goldstar971/Movin_on/kicad_files/digital_motor_signal_controllers/motor_controller_bottom.png

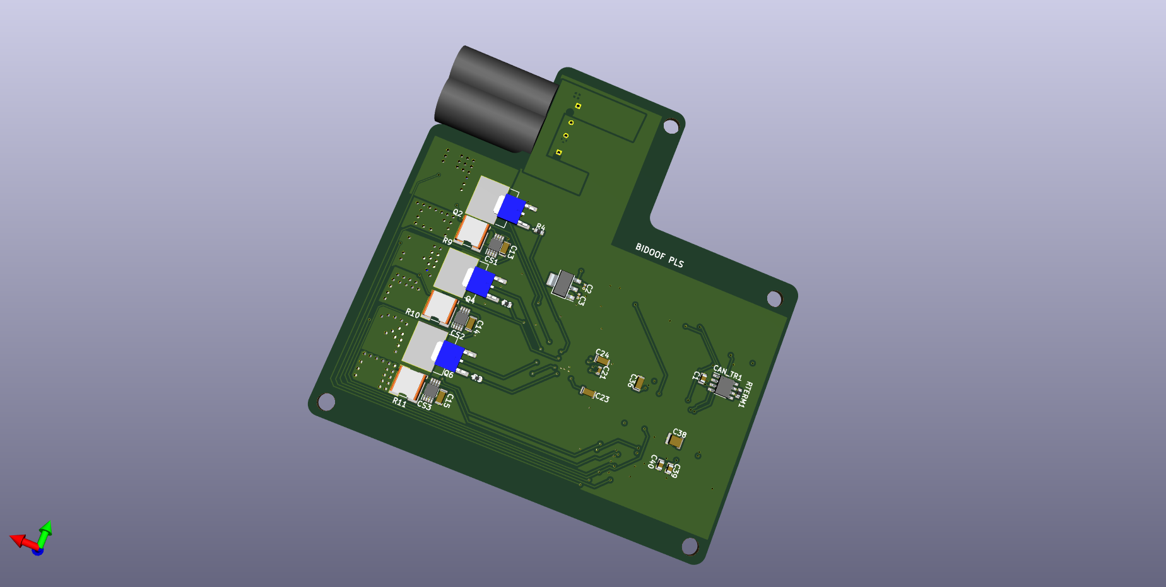
kicad_files/digital_motor_signal_controllers/motor_controller_bottom.png
