goldstar971/Movin_on/kicad_files/digital_motor_signal_controllers/bottom_view.png

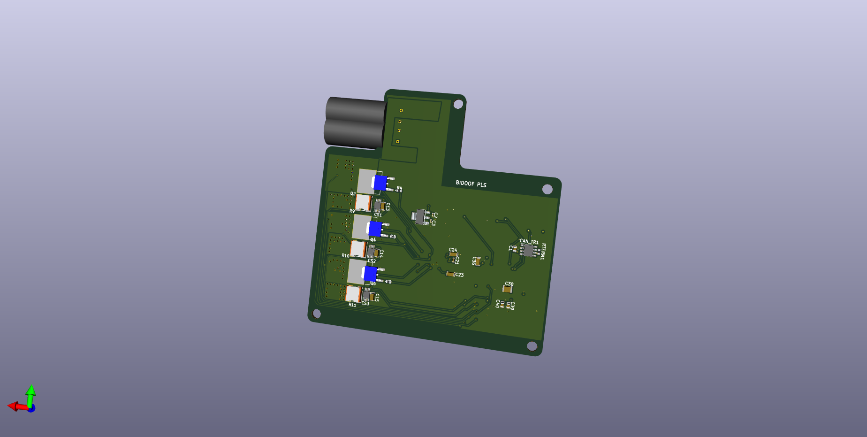
kicad_files/digital_motor_signal_controllers/bottom_view.png
