goldstar971/Movin_on/kicad_files/Wire_Pads.pretty-master/README.md

# Wire_Pads.pretty

## Note

This repository is now marked as read-only and will no longer accept pull requests. To contribute, refer to the new footprints library at https://github.com/kicad/kicad-footprints
