goldstar971/Movin_on/Problem_Statement_and_elucidation.odt

Problem Statement:

Electric longboards have been around for decades at this point. But current models suffer from numerous limitations and flaws that make them unappealing to the vast majority of potential consumers. Most have unnecessarily long ranges, being capable of going 10, 15, 20, or even more miles on a single charge even though that’s substantially in excess of what is needed for common use cases. This focus on a large range leads to correspondingly large batteries, significantly increasing the weight of an electric longboard to the detriment of portability, which is further impaired by the inherent length of a longboard. Current models of electric longboards are also controlled via a handheld remote, which is prone to loss or failure and makes braking and accelerating in a controlled manner difficult due to the lack of granularity and feedback. Additionally, the current steering mechanisms in electric longboards, the kingpin, exacerbate the control issues by rendering electric longboards unstable at high speeds.

The goal of this project is to design an electronically powered longboard that would be desirable to a significantly larger market than the current designs and which has a futuristic look to it that invokes feelings of freedom in the end-user. The focus would be on portability and ease of use, being collapsible such that it could fit inside of the average backpack, while being lightweight, and having a setup time of seconds. The prototype would have a max speed of at least 25 MPH and stability over the entire range of possible speeds. Further, it would incorporate a braking system, preferably regenerative, and be entirely hands-free with a control system that is integral to the longboard and manipulated via weight-shifting and foot placement.

Stakeholders:

- End Users: longboarders
- Customer: Michelin Tire Company.
- Manufacturer(s)
- MSD design team
- RIT
- Government Regulator: Consumer Product Safety Commission (for US).

Interview Questions:

- The initial requirements from the design readiness package mentioned that the prototype should be stable up to, at minimum, 25 MPH. What is meant by stability? (what category)
- What is the timeframe for a delivery of an initial design? (when category)
- What are some typical use cases you envision that endusers might purchase this device for? (why/who category).
