goldstar971/Movin_on/Three_week_plan_#3.odt

Team: Movin On Engineer: Matthew Gould

What were the outcomes of the prior phase?

1. What did I plan to do?
- Complete design and fabrication of acceleration control boards
- Prepare boards to be sent out for manufacture
2. What did I do?
- Halfway designed acceleration control boards
- Came to a better understanding of what I’m trying to accomplish in coding
- Figured out how we’d assemble our circuit boards
- Got quotes for PCB fabrication
- Figured out how we’d assemble the batteries.
3. What did I learn? How were plan and reality different?
  I was a lot busier than I thought and I was unable to accomplish a lot of what I had planned to. Next time I should make more realistic goals taking into account the other demands for my time.

Team level goal for next phase

What do I plan on doing to ensure that my team has a successful review at the end of the next phase?

1. Complete coding at least for Digital motor controller
2. Finish designing boards and send them off to be fabbed
3. Assist Kristin in assembling the PCBs.
