goldstar971/Movin_on/Use cases_Perliminary_use_cases.odt

Customer Requirements:

Importance requirement

10 Collapsible,

9 relatively light-weight

10 Handsfree, fully integrated control system.

8 Must have a break, preferably regeneratively.

9 Must have stability over the full range of speeds (maybe speed govenor).

9 Setup times measured in seconds

7 weather proofing

Use Case:

Transportation to run errands at places close-by. There needs to be either a convenient place to store items on the vehicle or handsfree control to allow one to hold items. It needs to be theft resistant when not in use i.e., not like a bike which are prone to theft when tied up in bike rafts. It needs to be easy to employ and relatively fast.
