goldstar971/Movin_on/invoices/motor_invoice.png

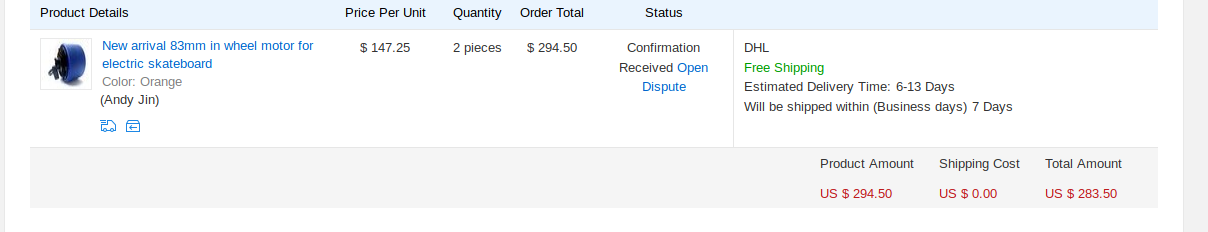
invoices/motor_invoice.png
