goldstar971/Movin_on/kicad_files/PCB schematics and other design stuff/FSR/ltspice_schematic.png

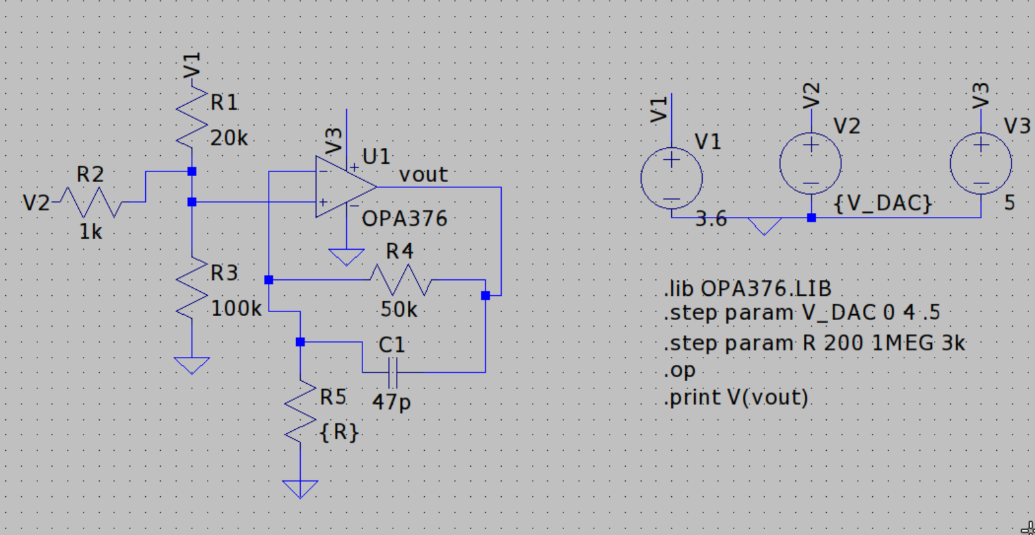
kicad_files/PCB schematics and other design stuff/FSR/ltspice_schematic.png
