goldstar971/Movin_on/BOMs/electrical_components_list_back_acceleration_control.ods

Schematic Label | Operating voltage | PART | Value | package | Description | QTY | mouser part number | digit key part_number | price($) | 3d model | footprint and symbol | notes:
C3, C4, C9-C11, C17, C18, C20, C21, C23, C25, C26, C32,C31 | 0-100 V | AS0805KKX7R0BB104 | .1uf | n\a | C=100 nF | 14 | 603-AS0805KKX7R0BB104 | n\a | 0.209 | yes | yes
C24, C27 | 0-50V | C3216X7R1H225K160AE | 2.2uf | n\a | C=2.2 uf | 2 | 810-C3216X7R1H225KST | n\a | 0.562 | yes | yes
C12, C13, C22 | 0-100 V | CGA6M3X7S2A475K200AB | 4.7uf | n\a | C=4.7 UF 100V | 3 | 810-CGA6M3X7S2A475K | n\a | 1.08 | yes | yes
C5,C6,C7, C8, C14, C15, C16 | 0-50 V | GRM1555C1H470FA01J | 47pf | n\a | C=47 pf | 7 | 81-GRM1555C1H470FA1J | n\a | 0.1 | yes | yes
C29 | 0-100 V | GRM21BR61E106KA73K | 10uf | n\a | C=10 uF | 1 | 81-GRM21BR61E106KA3K | n\a | 0.43 | yes | yes
C1, C2, C19 | 0-16 V | GRM155C81C105ME11J | 1 uf | n\a | C=1 uf | 3 | 81-GRM155C81C105ME11J | n\a | 0.27 | yes | yes
c28,c30 | 0-100 V | GRM155R62A104KE14D | .1uf | n\a | C=.1uf (size 0204) | 2 | 81-GRM155R62A104KE4D | n\a | 0.1 | yes | yes
IMU1 | 1.9 V to 3.6 V | LIS2DW12TR | n\a | LGA-12 | 3D digital linear acceleration sensor and 3d digital magnetic sensor, SPI/I^2C interfaces | 1 | 511-LIS2DW12TR | n\a | 2.38 | yes | yes
DAC1, DAC2 | 2.7-5.5 V | MAX5815BAUD+ | n\a | TSS0P-12 | Quad, 12-bit DAC with I^2C interface (Standard and Fast, Modes) | 2 | MAX5815BAUD+ | n\a | 5.08 | yes | yes
AMP1,AMP2 | 1.8-6 V | MCP6054-E/SL | n\a | SOIC-14 | Quad channel precision amplifier | 2 | 579-MCP6054-E/SL | n\a | 1.74 | yes | yes
R3, R7, R11, R19, R23, R27, R31 | n\a | mct0603pd1003dp500 | 100kohm | n\a | R=100 kohm .5% | 7 | mct0603pd1003dp500 | n\a | 0.57 | yes | yes
R2, R6, R10, R18, R22, R26, R30 | n\a | MCT0603PD2002DP500 | 20kohm | n\a | R=20 kohm .5% | 7 | 594-MCT0603PD2002DP5 | n\a | 0.57 | yes | yes
R1, R5, R9, R12, R13, R14, R16, R17, R21, R25, R29,R33, R34 | n\a | MCT0603PD4991DP500 | 4.99 kohm | n\a | R=4.99 kohm .5% | 13 | 594-MCT0603PD4991DP5 | n\a | 0.57 | yes | yes
R4, R8, R15, R20, R24, R28, R32 | n\a | MCT0603PD4992DP500 | 49.9 kohm | n\a | R=49.9 kohm .5% | 7 | 594-MCT0603PD4992DP5 | n\a | 0.57 | yes | yes
SWD1 | n\a | SM05B-PASS-TBT(LF)(SN) | n\a | n\a | 5 way, solderless terminal right angle shrouded male header,with 2mm pitch | 1 | Non-stocked | 455-2646-1-ND | 0.88 | yes | yes
BUSCNT1 | n\a | SM04B-PASS-TBT(LF)(SN) | n\a | n\a | 4 way, solderless terminal right angle shrouded male header,with 2mm pitch | 1 | Non-stocked | 455-2645-1-ND | 0.83 | yes | yes
CAN_TR1 | 3-3.6V | SN65HVD232DR | n\a | SOIC-8 | CAN transceiver, | 1 | 595-SN65HVD232DR | n\a | 1.95 | yes | yes
Accel_mc1 | 1.8-3.6 | STM32F205RBt6 | n\a | LQFP-64 | Cortex M3, 128kb FLASH, 120 MHZ 32-bit CPU, 64 KB RAM, 16 GPIO, CAN | 1 | 511-STM32F205RBT6 | n\a | 7.12 | yes | yes
Reg1 | 2.7-6 volts | TC2117-3.3VDBTR | n\a | SOT-223-3 | Low noise, 3.3 volt, .8A regulator | 1 | 579-TC2117-3.3VDBTR | n\a | 0.74 | yes | no | use 3d model of PN80R3K3P7ATMA1
 |  |  |  |  |  |  |  |  | 56.35
