goldstar971/Movin_on/BOMs/Electrical_components_list_motor_control.ods

Schematic Label | Operating voltage | Manufacturer part number | Value | package | Description | QTY | mouser part number | digit key part_number | price($) | 3d model | footprint and symbol | notes:
C1,C30,C39,C40,C41,C42,C43,C44,C45,C46 | 0-100 V | AS0805KKX7R0BB104 | .1uf | n\a | C=100 nF | 10 | 603-AS0805KKX70BB104 | n\a | 0.36 | yes | yes
C10,C11,C12 | 0-50V | GCM155R71H472KA37D | 4.7nf | n\a | C=4.7nF 50V | 3 | 81-GCM155R71H472K37D | n\a | 0.1 | yes | yes
C13,C14,C15,C16,C22,C23,C24,C25,C26,C36,C37 | 0-50V | C3216X7R1H225K160AE | 2.2uf | n\a | C=2.2 uf | 11 | 810-C3216X7R1H225KST | n\a | 0.562 | yes | yes
C17,C18 | 0-50V | UVR1H102MHD1TO | 1mf | n\a | C=1mF radial aluminum electrolytic capacitors | 2 | 647-UVR1H102MHD1T0 | n\a | 0.97 | yes | yes
C19 | 0-50V | CGA3E2C0G1H682J080AD | 6.8nf | m\a | C=6.8 nf | 1 | 810-CGA3E2C0G1H682JD | n\a | 0.39 | yes | yes
C2, C3,C35 | 0-16 V | GRM155C81C105ME11J | 1 uf | n\a | C=1 uf | 3 | 81-GRM155C81C105ME11J | n\a | 0.27 | yes | yes
C20 | 0-50V | C0603C121J5GACTU | 120pf | m\a | C=120 pf | 1 | 80-C0603C121J5G | n\a | 0.1 | yes | yes
C21 | 0-50v | CGA3E2X7R1H223K080AA | 22nf | m\a | C=22 nf | 1 | 810-CGA3E2X7R1H223K | n\a | 0.1 | yes | yes
C27,C28,C29 | 0-25V | GRM033R61E224KE01D | 220nf | m\a | C=220 nf | 3 | 81-GRM033R61E224KE1D | n\a | 0.1 | yes | yes
C34 | 0-6.3V | 875015119003 | 100uf | m\a | C=100uf aluminum organic polymer | 1 | 81-GRM033R61E224KE1D | n\a | 1.87 | yes | yes
C31 | 0-25 V | C0603C153J3GACTU | 15nf | m\a | C=15 nf | 1 | 80-C0603C153J3G | n\a | 0.42 | yes | yes
C4,C5,C6,C7,C8,C9,C32,C33,C38 | 0-100 V | CGA6M3X7S2A475K200AB | 4.7uf | n\a | C=4.7 UF 100V | 9 | 810-CGA6M3X7S2A475K | n\a | 1.08 | yes | yes
CAN_TR1 | 3-3.6V | SN65HVD232DR | n\a | SOIC-8 | CAN transceiver, | 1 | 595-SN65HVD232DR | n\a | 1.95
CS1,CS2,CS3 | 2.7-5.5V | AD8418ABRMZ | n\a | MSOP-8 | current sense amplifier, 100 DB CMRR 20 V/V gain, bidirectional, zero drift | 3 | 584-AD8418ABRMZ | n\a | 2.76 | yes | yes
D1 | 0-60V | PMEG6020ER-115 | 60V, 2A, | SOD-123W-2 | Schottky diode, 60V 2A | 1 | 771-PMEG6020ER-115 | n\a | 0.35 | yes | no | Use footprint and symbol of PMEG6010ER
D2 | n\a | LTST-C191KGKT | n\a | SMD 0603 | LED Green, 0603 | 1 | 859-LTST-C191KGKT | n\a | 0.26 | yes | no | model is of capacitor, but it has same dimensions as LED
D3 | n\a | LTST-C191KRKT | n\a | SMD 0604 | LED Red, 0603 | 1 | 859-LTST-C191KRKT | n\a | 0.26 | yes | no | model is of capacitor, but it has same dimensions as LED
DRV | 8-60 | DRV8302DCAR | n\a | HTSSOP-56 | 3 Phase Motor Pre-driver, 1.5 amp buck converter, 2 high accuracy current sensors, | 1 | 595-DRV8302DCAR | n\a | 5.82 | yes | yes
DSC | 1.8-3.6 | STM32F765VIT6 | n\a | LQFP-100 | Cortex M7, 2MB FLASH, 216 MHz 32-bit CPU 512KB RAM, 140 GPIO,CAN | 1 | 511-STM32F765VIT6 | n\a | 14.33 | yes | yes
L1 | n\a | SDR0805-220ML | 22uh | m\a | Power inductor with L=22uh and 1.5 A max forward current | 1 | 652-SDR0805-220ML | n\a | 0.57 | yess | yes
Q1,Q2,Q3,Q4,Q5,Q6 | n\a | IRFS7730TRLPBF | n\a | TO-252-3 | 1 Channel Power NMOS, 75 volt Vds, 195 A drain current | 6 | 942-IRFS7730TRLPBF | n\a | 2.37 | yes | no | Use 3d model of BA17805FP-E2
R1,R2,R12,R13,R14 | m\a | RK73H1JTTD1000F | 100ohm | n\a | R=100 ohm | 5 | 660-RK73H1JTTD1000F | n\a | 0.1 | yes | yes
R15,R21 | n\a | RK73H1JTTD1002F | 10kohm | n\a | R=10 kohm | 1 | 660-RK73H1JTTD1002F | n\a | 0.11 | yes | yes
R16 | n\a | RK73H1JTTD3301F | 3.3kohms | m\a | R=3.3 kohms | 1 | 660-RK73H1JTTD3301F | n\a | 0.11 | yes | yes
R17 | n\a | RK73H1JTTD1802F | 18kohm | m\a | R=18 kohm | 1 | 660-RK73H1JTTD1802F | n\a | 0.11 | yes | yes
R18 | n\a | RK73H1JTTD1502F | 15kohms | m\a | R=15 kOhm | 1 | e | n\a | 0.11 | yes | yes
R19 | n\a | RK73H1JTTD2203F | 220kohm | m\a | R=220 kohm | 1 | 660-RK73H1JTTD2203F | n\a | 0.11 | yes | yes
R20 | m\a | RK73H1JTTD1004F | 1000kohm | n\a | R=1000 kohm | 1 | 660-RK73H1JTTD1004F | n\a | 0.11 | yes | yes
R22,R23,R24,R25 | n\a | RK73H1JTTD2201F | 2.2kohms | m\a | R=2.2 kohms | 4 | 660-RK73H1JTTD2201F | n\a | 0.11 | yes | yes
R26,R27,R28,R29 | n\a | ERJ-3EKF3902V | 39kohms | n\a | R=39 kohms | 4 | 667-ERJ-3EKF3902V | n\a | 0.1 | yes | yes
R3,R4,R5,R6,R7,R8 | n\a | RK73H1JTTD4R70F | 4.7ohms | n\a | R=4.7 ohms | 6 | 660-RK73H1JTTD4R70F | n\a | 0.1 | yes | yes
R9,R10,R11 | n\a | WSLP27261L000FEA | 1mohm | m\a | Shunt with resistance 1 mohm | 3 | 71-WSLP27261L000FEA | n\a | 3 | yes | no | must import step file into library
RECV1, BUSCNT1 | n\a | SM04B-PASS-TBT(LF)(SN) | n\a | n\a | 4 way, solderless terminal right angle shrouded male header,with 2mm pitch | 2 | Non-stocked | 455-2645-1-ND | 0.83 | yes | yes
Reg1 | 2.7-6 volts | TC2117-3.3VDBTR | n\a | SOT-223-3 | Low noise, 3.3 volt, .8A regulator | 1 | 579-TC2117-3.3VDBTR | n\a | 0.74 | no | no | use 3d model of PN80R3K3P7ATMA1
RTEMP1 | n\a | NCP18XH103F03RB | n\a | n\a | thermistors for measuring motor and fet temperature 10kohm 1% | 1 | 81-NCP18XH103F03RB | n\a | 0.22 | yes | yes
Rterm1 | n\a | ERA-3AEB121V | 120 ohm | m\a | R=120 ohm for can | 1 | 667-ERA-3AEB121V | n\a | 0.58 | yes | yes
SWD1 | n\a | SM05B-PASS-TBT(LF)(SN) | n\a | n\a | 5 way, solderless terminal right angle shrouded male header,with 2mm pitch | 1 | Non-stocked | 455-2646-1-ND | 0.88 | yes | yes
D4 | n\a | 576-SMAJ5.0A | n\a | DO-214AC | TVS diode 5V | 1 | SMAJ5.0A | n\a | 0.43 | yes | yes
 |  |  |  |  |  |  |  |  |  | 87.882
