goldstar971/Movin_on/BOMs/non_pcb_electrical_components.ods

Part number or link | Cost | Description | QTY | Supplier
455-1488-ND | 0.17 | mating connector for SM04B-PASS-TBT(LF)(SN) | 6 | digit key
455-1489-ND | 0.17 | mating connector for SM05B-PASS-TBT(LF)(SN) | 8 | digit key
455-3086-ND | 0.3932 | jumper for PAP connectors | 16 | digit key
2548 | 12.5 | ST-Link STM8/STM32 v2 Programmer & Emulator | 1 | adafruit
S-20-1000-FS15 | 7.95 | 1.5”x1.75” FSR | 13 | trossen robotics
455-1551-ND | 0.18 | panel mount 5 pos PAL connector (for interconnection between swd adapater and boards | 4 | digit key
455-3089-ND | 0.486 | 12’’ precrimped wires for panel mount | 16 | digit key
 |  |  | 133.02
