goldstar971/Movin_on/BOMs/pcb_quotes.ods

 | Fabrication |  | Assembly
manufacturer | price | quantity | price | quantity | total cost | US?
PCB way | 128 | 5 | 88 | 2 | 216 | No
OSH Park | 172.2 | 3 | n\a | n\a | 172.2 | yes
advanced circuits | 140.1 | 5 | 303.27 | 2 | 443.37 | yes
