goldstar971/Movin_on/kicad_files/Forward_acceleration_board/my_fields.xlsx

Refs | Description | Height | Manufacturer_Name | Manufacturer_Part_Number | Mouser Part Number | Mouser Price/Stock | RS Part Number | RS Price/Stock | datasheet | footprint | value
Accel_mc1 |  | 1.6 | STMicroelectronics | STM32F205RBT6 | 511-STM32F205RBT6 | https://www.mouser.com/Search/Refine.aspx?Keyword=511-STM32F205RBT6 |  |  | https://componentsearchengine.com/Datasheets/1/STM32F205RBT6.pdf | QFP50P1200X1200X160-64N | STM32F205RBT6
BUSCNT1 | CONN HEADER PA 5POS SIDE SMD |  | JST (JAPAN SOLDERLESS TERMINALS) | SM05B-PASS-TBT(LF)(SN) |  |  |  |  | http://www.jst-mfg.com/product/pdf/eng/ePA-F.pdf | SM05BPASSTBTLFSN | SM05B-PASS-TBT(LF)(SN)
C1, C19 | Multilayer Ceramic Capacitors MLCC - SMD/SMT | 0.55 | Murata Electronics | GRM155C81C105ME11J | 81-GRM155C81C105ME1J | https://www.mouser.com/Search/Refine.aspx?Keyword=81-GRM155C81C105ME1J |  |  | http://www.murata.com/~/media/webrenewal/support/library/catalog/products/capacitor/mlcc/c02e.pdf | CAPC1005X55N | 1u
C3, C4, C9-C11, C17, C18, C20, C21, C23, C25, C26, C28 | Multilayer Ceramic Capacitors MLCC - SMD/SMT 0.1uF 10% 100V AEC-Q200 | 1.45 | YAGEO (PHYCOMP) | AS0805KKX7R0BB104 | 603-AS0805KKX70BB104 | https://www.mouser.com/Search/Refine.aspx?Keyword=603-AS0805KKX70BB104 |  |  | https://mouser.componentsearchengine.com/Datasheets/1/AS0805KKX7R0BB104.pdf | CAPC2012X145N | .1u
C12, C13, C22 | TDK 4.7uF Multilayer Ceramic Capacitor MLCC 100V dc +/-10% X7S Dielectric 1210 (3225M) SMD, Max. Temp. +125C | 2 | TDK | CGA6M3X7S2A475K200AB | 810-CGA6M3X7S2A475K | https://www.mouser.com/Search/Refine.aspx?Keyword=810-CGA6M3X7S2A475K | 9155415P | http://uk.rs-online.com/web/p/products/9155415P | https://componentsearchengine.com/Datasheets/1/CGA6M3X7S2A475K200AB.pdf | CAPC3225X200N | 4.7u
C5-C8, C14-C16 | Multilayer Ceramic Capacitors MLCC - SMD/SMT 0402 47pF 50volts C0G 1% | 0.55 | Murata Electronics | GRM1555C1H470FA01J | 81-GRM1555C1H470FA1J | https://www.mouser.com/Search/Refine.aspx?Keyword=81-GRM1555C1H470FA1J |  |  | https://componentsearchengine.com/Datasheets/1/GRM1555C1H470FA01J.pdf | CAPC1005X55N | 47p
C2 | Multilayer Ceramic Capacitors MLCC - SMD/SMT | 0.55 | Murata Electronics | GRM155C81C105ME11J | 81-GRM155C81C105ME1J | https://www.mouser.com/Search/Refine.aspx?Keyword=81-GRM155C81C105ME1J |  |  | http://www.murata.com/~/media/webrenewal/support/library/catalog/products/capacitor/mlcc/c02e.pdf | CAPC1005X55N | 1u
C24, C27 | Multilayer Ceramic Capacitors MLCC - SMD/SMT 3216 2.2uF 50volts X7R 10% Soft Term | 1.8 | TDK | C3216X7R1H225K160AE | 810-C3216X7R1H225KST | https://www.mouser.com/Search/Refine.aspx?Keyword=810-C3216X7R1H225KST |  |  | https://product.tdk.com/info/en/catalog/datasheets/mlcc_commercial_midvoltage_en.pdf | CAPC3216X180N | 2.2u
C29 | Multilayer Ceramic Capacitors MLCC - SMD/SMT 0.1uF 10% 100V AEC-Q200 | 1.45 | YAGEO (PHYCOMP) | AS0805KKX7R0BB104 | 603-AS0805KKX70BB104 | https://www.mouser.com/Search/Refine.aspx?Keyword=603-AS0805KKX70BB104 |  |  | https://mouser.componentsearchengine.com/Datasheets/1/AS0805KKX7R0BB104.pdf | CAPC2012X145N | 10u
C30 | Multilayer Ceramic Capacitors MLCC - SMD/SMT 10UF 4V 20% 0402 | 0.55 | Murata Electronics | GRM155C80G106ME44D | 81-GRM155C80G106ME44 | https://www.mouser.com/Search/Refine.aspx?Keyword=81-GRM155C80G106ME44 |  |  | https://componentsearchengine.com/Datasheets/1/GRM155C80G106ME44D.pdf | CAPC1005X55N | .1u
CAN_TR1 | 3.3 V CAN Transceiver | 1.75 | Texas Instruments | SN65HVD232DR | 595-SN65HVD232DR | https://www.mouser.com/Search/Refine.aspx?Keyword=595-SN65HVD232DR |  |  | http://www.ti.com/lit/gpn/sn65hvd232 | SN65HVD232DR:SOIC127P600X175-8N | SN65HVD232DR
IC1, IC2 | Quad 1.8V 300kHz Op Amp, E temp | 1.75 | Microchip | MCP6054-E/SL | 579-MCP6054-E/SL | https://www.mouser.com/Search/Refine.aspx?Keyword=579-MCP6054-E%2FSL |  |  | https://componentsearchengine.com/Datasheets/1/MCP6054-E_SL.pdf | SOIC127P600X175-14N | MCP6054+E_SL
IC3, IC4 | Digital to Analog Converters - DAC MAX5815 Eval Kit | 1.1 | Maxim Integrated | MAX5815BAUD+ | 700-MAX5815BAUD+ | https://www.mouser.com/Search/Refine.aspx?Keyword=700-MAX5815BAUD%2B |  |  | https://componentsearchengine.com/Datasheets/1/MAX5815BAUD+.pdf | SOP65P640X110-14N | MAX5815BAUD+
IMU1 | STMICROELECTRONICS - LIS2DTW12TR - MEMS MODULE, TRI-AXIS ACCELEROMETER | 0.7 | STMicroelectronics | LIS2DTW12TR | 511-LIS2DTW12TR | https://www.mouser.com/Search/Refine.aspx?Keyword=511-LIS2DTW12TR |  |  | https://componentsearchengine.com/Datasheets/1/LIS2DTW12TR.pdf | IIS2MDCTR | LIS2DTW12TR
J3-J16 |  |  |  |  |  |  |  |  | ~ |  | Conn_01x01_Male
R1, R5, R9, R12-R14, R16, R17, R21, R25, R29, R33, R34 | Thin Film Resistors - SMD .250W 4.99Kohms .5% 0603 25ppm Hi Power | 0.55 | Vishay | MCT0603PD4991DP500 | 594-MCT0603PD4991DP5 | https://www.mouser.com/Search/Refine.aspx?Keyword=594-MCT0603PD4991DP5 |  |  | https://componentsearchengine.com/Datasheets/1/MCT0603PD4991DP500.pdf | RESC1608X55N | 5k
R2, R6, R10, R18, R22, R26, R30 | Thin Film Resistors - SMD .250W 20Kohms .5% 0603 25ppm Hi Power | 0.55 | Vishay | MCT0603PD2002DP500 | 594-MCT0603PD2002DP5 | https://www.mouser.com/Search/Refine.aspx?Keyword=594-MCT0603PD2002DP5 |  |  | https://componentsearchengine.com/Datasheets/1/MCT0603PD2002DP500.pdf | RESC1608X55N | 20k
R3, R7, R11, R19, R23, R27, R31 | Thin Film Resistors - SMD .250W 100Kohms .5% 0603 25ppm Hi Power | 0.55 | Vishay | MCT0603PD1003DP500 | 594-MCT0603PD1003DP5 | https://www.mouser.com/Search/Refine.aspx?Keyword=594-MCT0603PD1003DP5 |  |  | https://componentsearchengine.com/Datasheets/1/MCT0603PD1003DP500.pdf | RESC1608X55N | 100k
R4, R8, R15, R20, R24, R28, R32 | Thin Film Resistors - SMD .250W 49.9Kohms .5% 0603 25ppm Hi Power | 0.55 | Vishay | MCT0603PD4992DP500 | 594-MCT0603PD4992DP5 | https://www.mouser.com/Search/Refine.aspx?Keyword=594-MCT0603PD4992DP5 |  |  | https://componentsearchengine.com/Datasheets/1/MCT0603PD4992DP500.pdf | RESC1608X55N | 50k
Reg1 | Microchip TC2117-3.3VDBTR, LDO Voltage Regulator, 800mA, 3.3 V +/-0.5%, 2.7 6 Vin, 3-Pin SOT-223 | 1.8 | Microchip | TC2117-3.3VDBTR | 579-TC2117-3.3VDBTR | https://www.mouser.com/Search/Refine.aspx?Keyword=579-TC2117-3.3VDBTR | 8234434 | https://uk.rs-online.com/web/p/products/8234434 | https://componentsearchengine.com/Datasheets/2/TC2117-3.3VDBTR.pdf | SOT230P700X180-4N | TC2117
SWD1 | JST (JAPAN SOLDERLESS TERMINALS) - SM04B-PASS-TBT(LF)(SN) - CONNECTOR, HEADER, 4POS, 1ROW, 2MM |  | JST (JAPAN SOLDERLESS TERMINALS) | SM04B-PASS-TBT(LF)(SN) |  |  |  |  | http://www.jst-mfg.com/product/pdf/eng/ePA-F.pdf | SM04B-PASS-TBT | SM04B-PASS-TBT(LF)(SN)
