goldstar971/Movin_on/kicad_files/Forward_acceleration_board/P-00019E - FSR Board.DXF

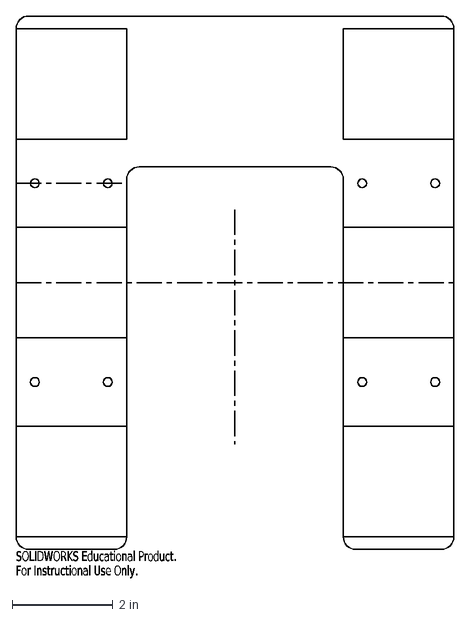
[picture p13: CAD file, 2019-10-20]
kicad_files/Forward_acceleration_board/P-00019E - FSR Board.DXF
SOLIDWORKS Educational Product.
For Instructional Use Only.
