goldstar971/Movin_on/kicad_files/PCB schematics and other design stuff/FSR/FSR.DXF

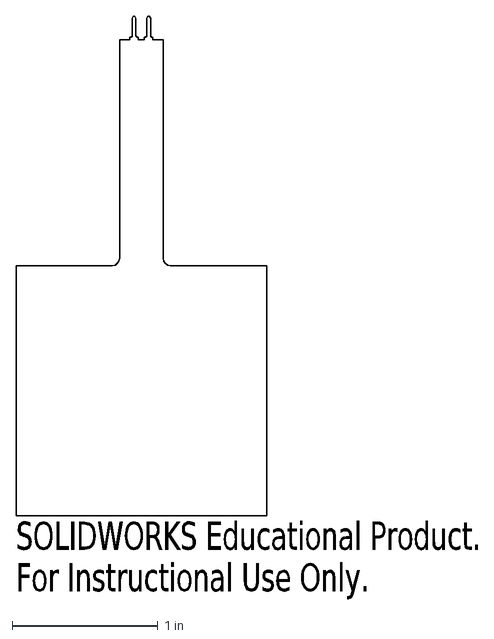
[picture p14: CAD file, 2019-10-20]
kicad_files/PCB schematics and other design stuff/FSR/FSR.DXF
SOLIDWORKS Educational Product.
For Instructional Use Only.
