goldstar971/Movin_on/Models/Acceleration_control_models/GRM155R62A104KE14D/3D/GRM155R62A104KE14D.stp

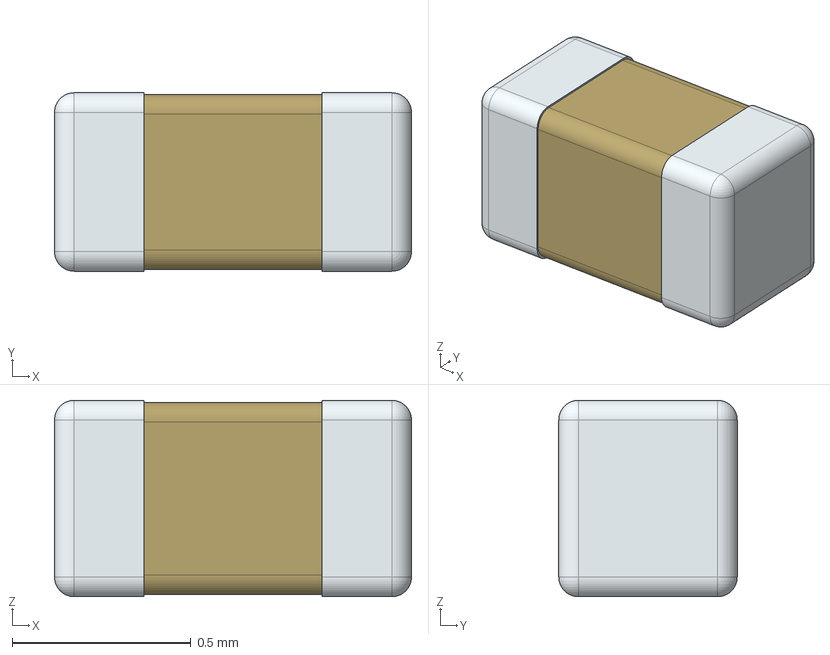
[picture p15: CAD file, 2019-11-22]
Models/Acceleration_control_models/GRM155R62A104KE14D/3D/GRM155R62A104KE14D.stp
1.00 x 0.5 x 0.55 mm
