goldstar971/Movin_on/Models/Acceleration_control_models/GRM21BR61E106KA73K/3D/GRM21BR61E106KA73K.stp

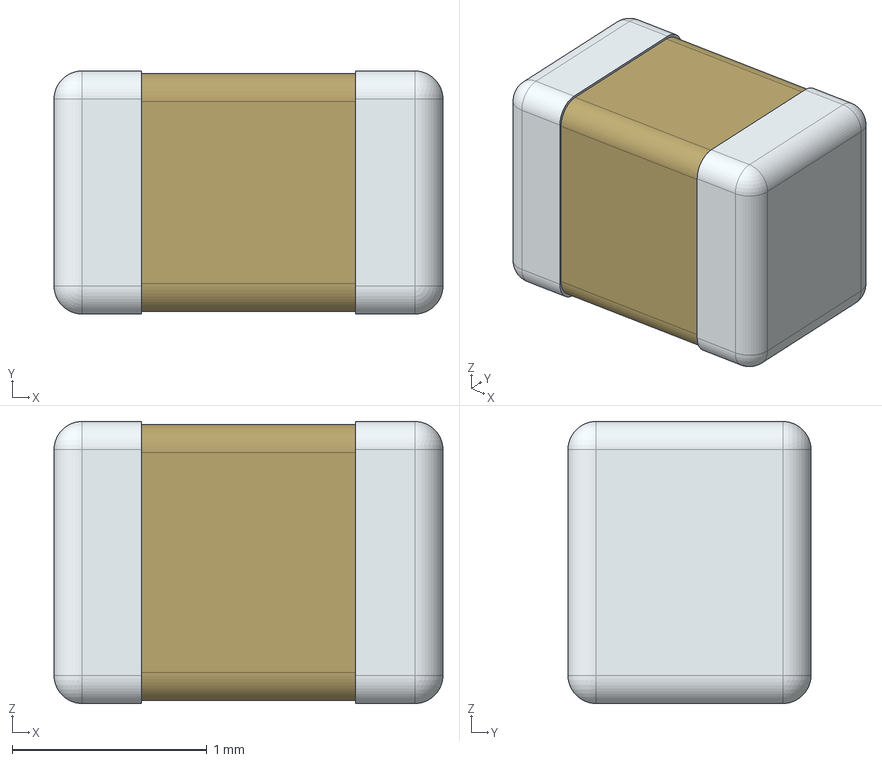
[picture p16: CAD file, 2019-11-22]
Models/Acceleration_control_models/GRM21BR61E106KA73K/3D/GRM21BR61E106KA73K.stp
2.00 x 1.25 x 1.45 mm
