goldstar971/Movin_on/Models/Acceleration_control_models/Kicad_3D/MAX5815BAUD+.stp

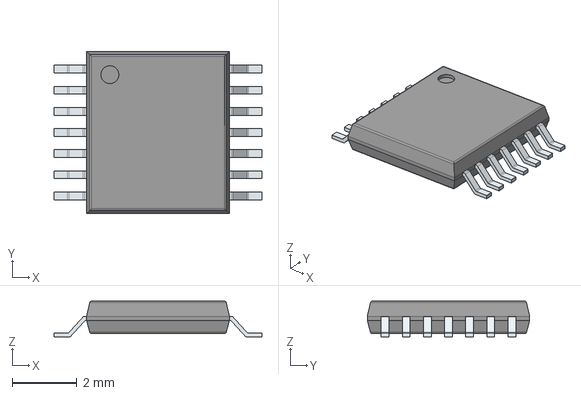
[picture p17: CAD file, 2019-10-09]
Models/Acceleration_control_models/Kicad_3D/MAX5815BAUD+.stp
6.40 x 5.00 x 1.10 mm
PinsArrayLR
