goldstar971/Movin_on/Models/Acceleration_control_models/LIB_C3216X7R1H225K160AE/C3216X7R1H225K160AE/3D/C3216X7R1H225K160AE.stp

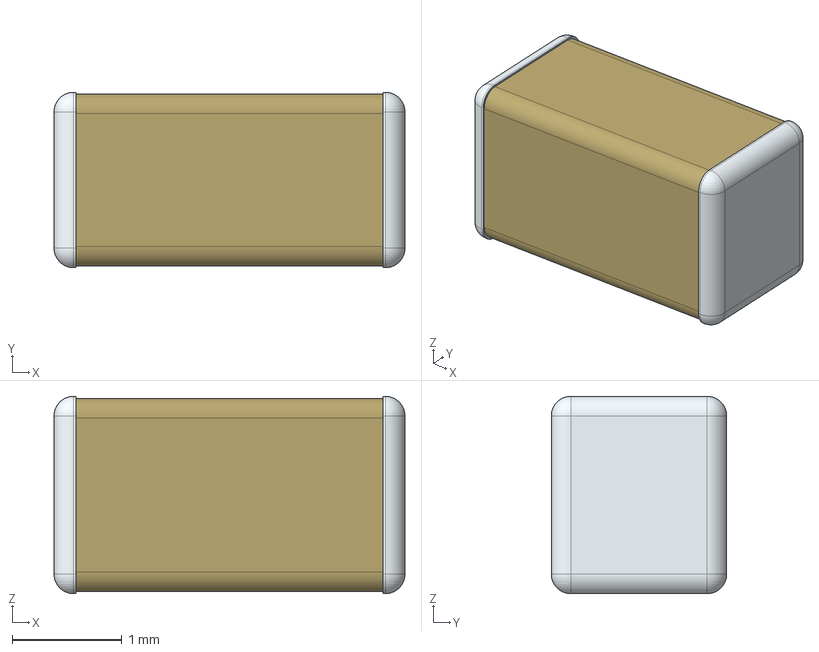
[picture p18: CAD file, 2019-08-06]
Models/Acceleration_control_models/LIB_C3216X7R1H225K160AE/C3216X7R1H225K160AE/3D/C3216X7R1H225K160AE.stp
3.20 x 1.60 x 1.80 mm
