goldstar971/Movin_on/Models/Acceleration_control_models/LIB_CGA6M3X7S2A475K200AB/CGA6M3X7S2A475K200AB/3D/CGA6M3X7S2A475K200AB.stp

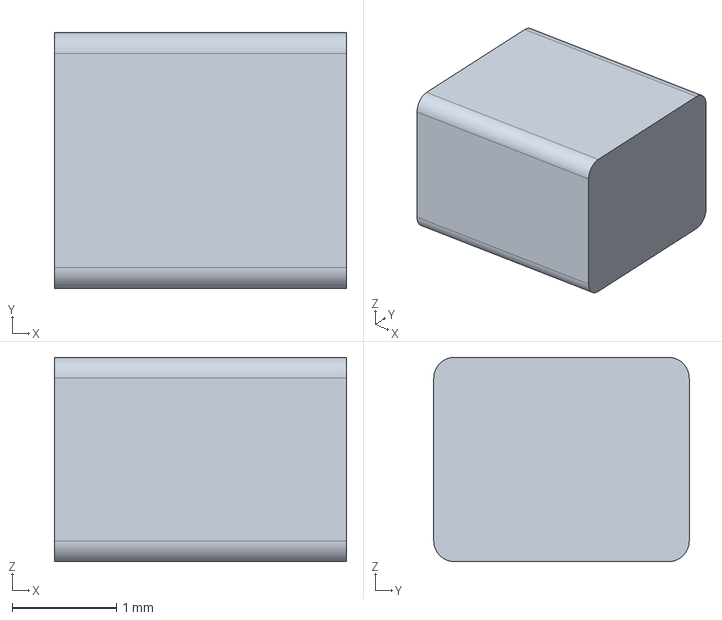
[picture p19: CAD file, 2019-08-06]
Models/Acceleration_control_models/LIB_CGA6M3X7S2A475K200AB/CGA6M3X7S2A475K200AB/3D/CGA6M3X7S2A475K200AB.stp
2.80 x 2.45 x 1.96 mm
