goldstar971/Movin_on/Models/Acceleration_control_models/LIB_MCP6054-E_SL/MCP6054-E_SL/3D/MCP6054-E_SL.stp

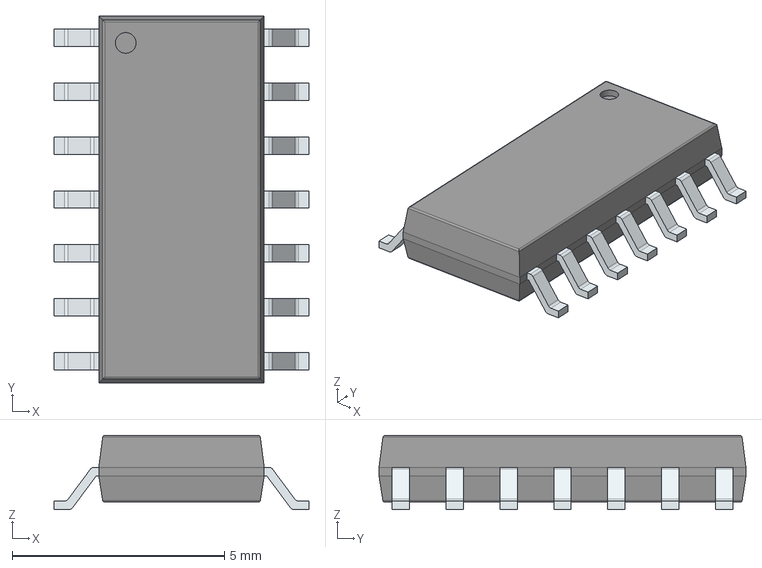
[picture p20: CAD file, 2019-09-30]
Models/Acceleration_control_models/LIB_MCP6054-E_SL/MCP6054-E_SL/3D/MCP6054-E_SL.stp
6.00 x 8.65 x 1.75 mm
PinsArrayLR
