goldstar971/Movin_on/Models/Acceleration_control_models/LIB_MCT0603PD1003DP500/MCT0603PD1003DP500/3D/MCT0603PD1003DP500.stp

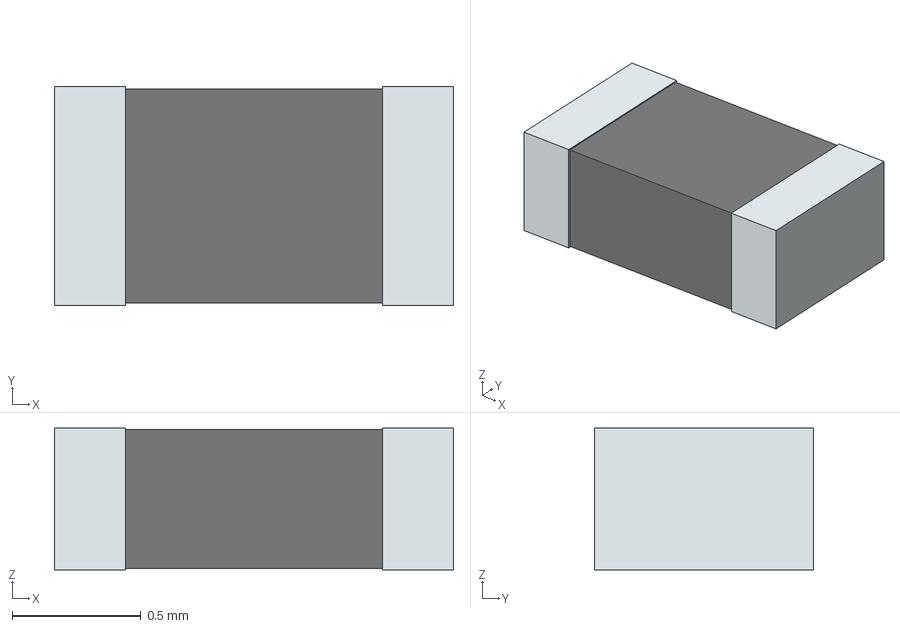
[picture p21: CAD file, 2019-09-30]
Models/Acceleration_control_models/LIB_MCT0603PD1003DP500/MCT0603PD1003DP500/3D/MCT0603PD1003DP500.stp
1.55 x 0.85 x 0.55 mm
term1
term2
