goldstar971/Movin_on/Models/Acceleration_control_models/LIB_SM04B-PASS-TBT(LF)(SN)/SM04B-PASS-TBT(LF)(SN)/3D/S4B-PH-SM4-TB.stp

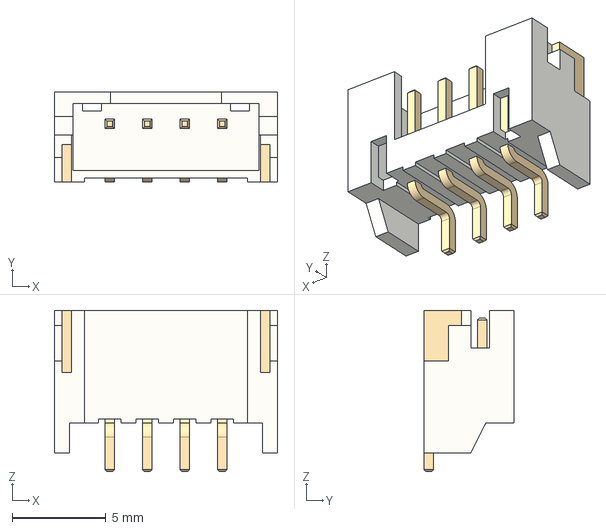
[picture p22: CAD file, 2019-08-06]
Models/Acceleration_control_models/LIB_SM04B-PASS-TBT(LF)(SN)/SM04B-PASS-TBT(LF)(SN)/3D/S4B-PH-SM4-TB.stp
11.9 x 4.80 x 8.60 mm
