goldstar971/Movin_on/Models/Acceleration_control_models/LIB_SM05B-PASS-TBT(LF)(SN)/SM05B-PASS-TBT(LF)(SN)/3D/S5B-PH-SM4-TB.stp

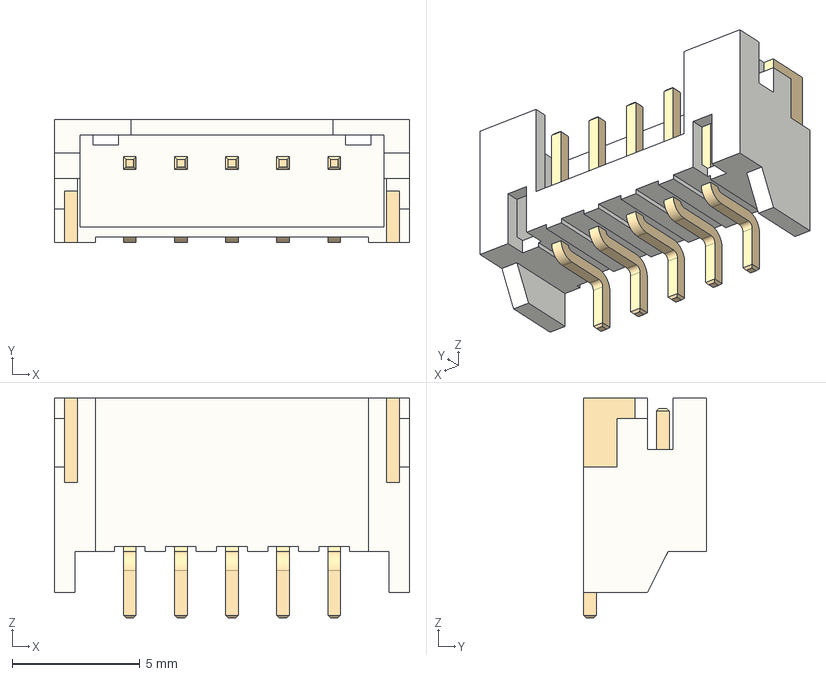
[picture p23: CAD file, 2019-08-06]
Models/Acceleration_control_models/LIB_SM05B-PASS-TBT(LF)(SN)/SM05B-PASS-TBT(LF)(SN)/3D/S5B-PH-SM4-TB.stp
13.9 x 4.80 x 8.60 mm
