goldstar971/Movin_on/Models/Acceleration_control_models/LIB_SN65HVD232DR/SN65HVD232DR/3D/SN65HVD232DR.stp

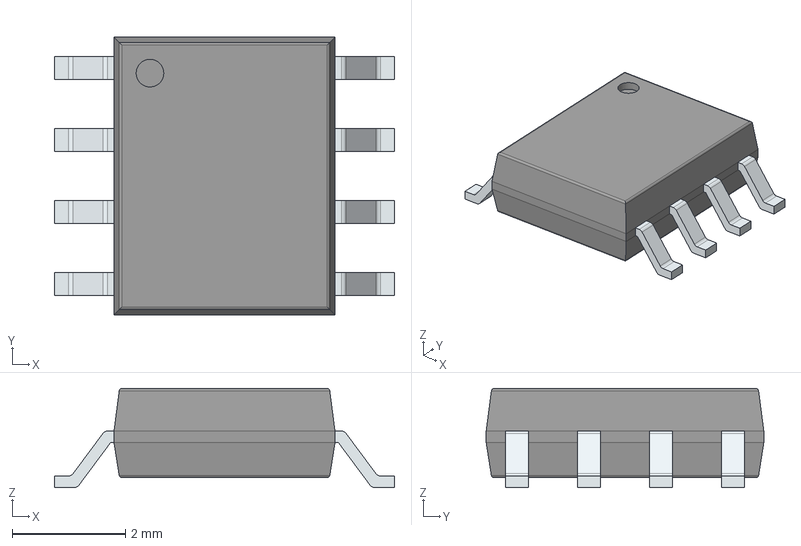
[picture p24: CAD file, 2019-08-06]
Models/Acceleration_control_models/LIB_SN65HVD232DR/SN65HVD232DR/3D/SN65HVD232DR.stp
6.00 x 4.90 x 1.75 mm
PinsArrayLR
