goldstar971/Movin_on/Models/Acceleration_control_models/LIB_TC2117-3.3VDBTR/TC2117-3.3VDBTR/3D/TC2117-3.3VDBTR.stp

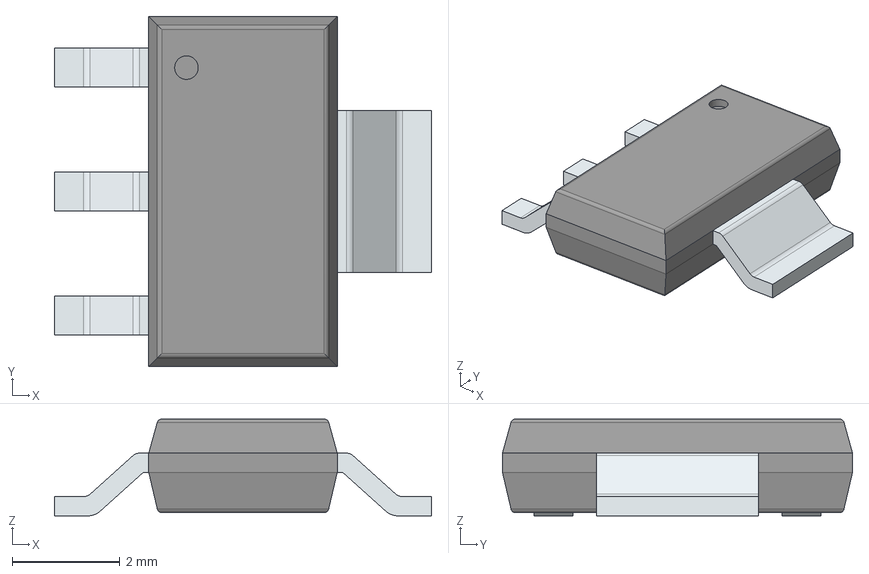
[picture p25: CAD file, 2019-08-06]
Models/Acceleration_control_models/LIB_TC2117-3.3VDBTR/TC2117-3.3VDBTR/3D/TC2117-3.3VDBTR.stp
7.00 x 6.50 x 1.80 mm
PinsArrayL
FilletPinR
