goldstar971/Movin_on/Models/Acceleration_control_models/STM32F205RBT6/3D/STM32F205RBT6.stp

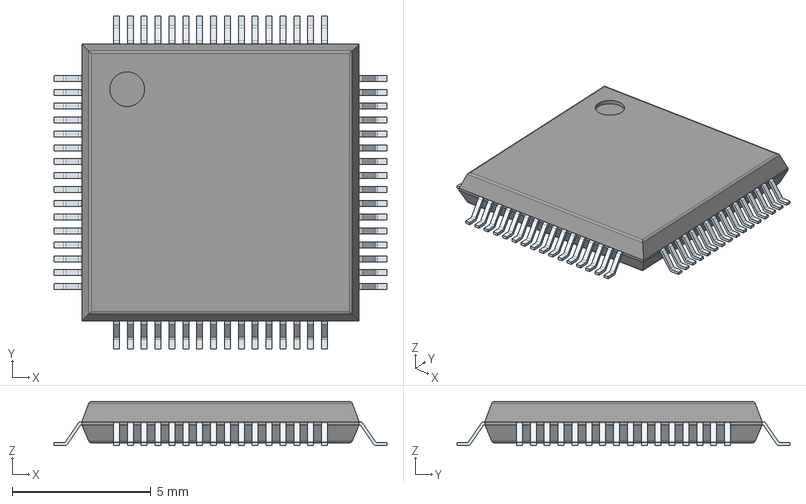
[picture p26: CAD file, 2019-09-30]
Models/Acceleration_control_models/STM32F205RBT6/3D/STM32F205RBT6.stp
12.0 x 12.0 x 1.60 mm
PinsArrayLR
PinsArrayTB
