goldstar971/Movin_on/Models/Models_motor_control/LIB_AD8418ABRMZ/AD8418ABRMZ/3D/AD8418ABRMZ.stp

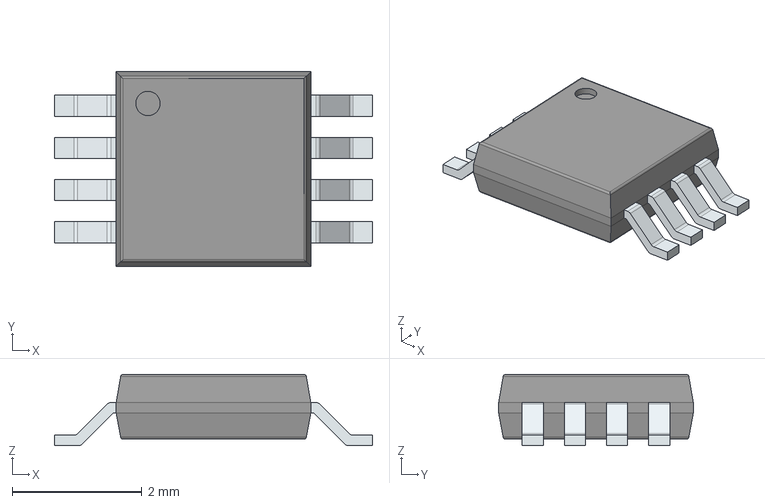
[picture p27: CAD file, 2019-08-06]
Models/Models_motor_control/LIB_AD8418ABRMZ/AD8418ABRMZ/3D/AD8418ABRMZ.stp
4.90 x 3.00 x 1.10 mm
PinsArrayLR
