goldstar971/Movin_on/Models/Models_motor_control/LIB_C0603C121J5GACTU/C0603C121J5GACTU/3D/C0603C121J5GACTU.stp

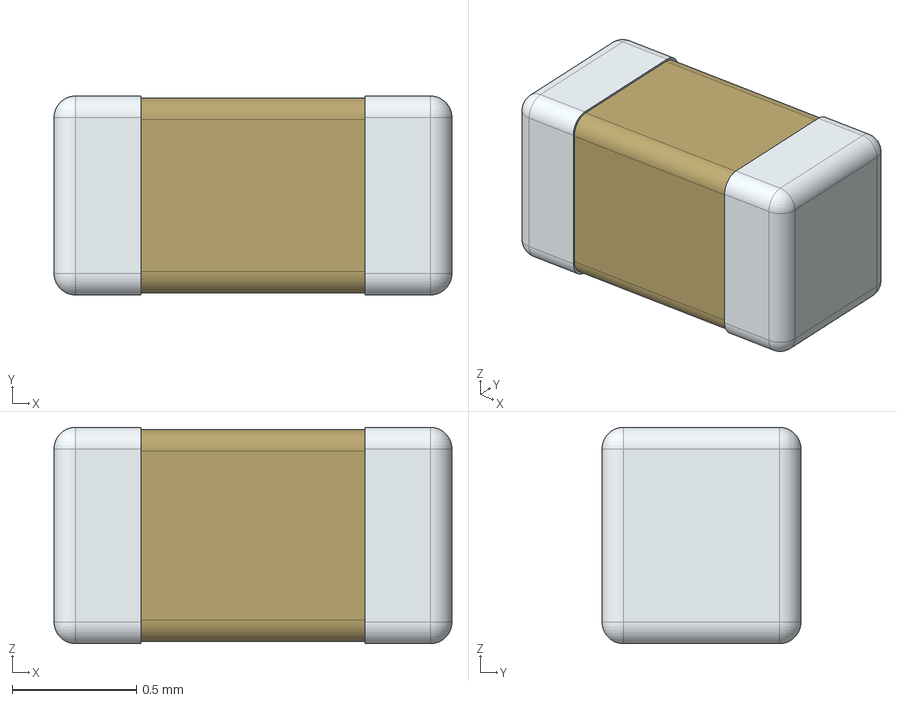
[picture p28: CAD file, 2019-08-06]
Models/Models_motor_control/LIB_C0603C121J5GACTU/C0603C121J5GACTU/3D/C0603C121J5GACTU.stp
1.60 x 0.8 x 0.87 mm
