goldstar971/Movin_on/Models/Models_motor_control/LIB_CGA3E2C0G1H682J080AD/CGA3E2C0G1H682J080AD/3D/CGA3E2C0G1H682J080AD.stp

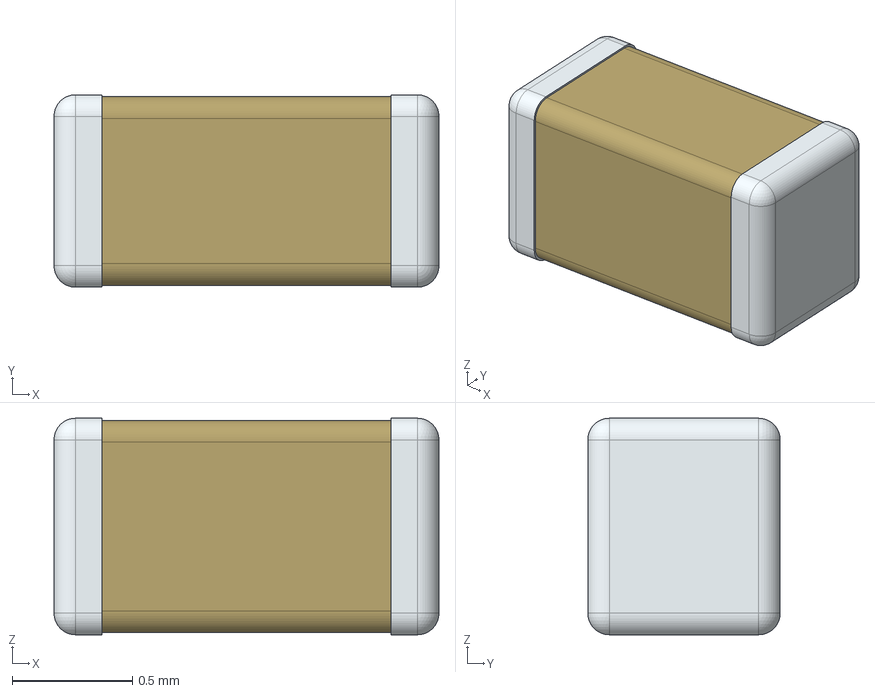
[picture p29: CAD file, 2019-08-06]
Models/Models_motor_control/LIB_CGA3E2C0G1H682J080AD/CGA3E2C0G1H682J080AD/3D/CGA3E2C0G1H682J080AD.stp
1.60 x 0.8 x 0.9 mm
