goldstar971/Movin_on/Models/Models_motor_control/LIB_DRV8302DCAR/DRV8302DCAR/3D/DRV8302DCAR.stp

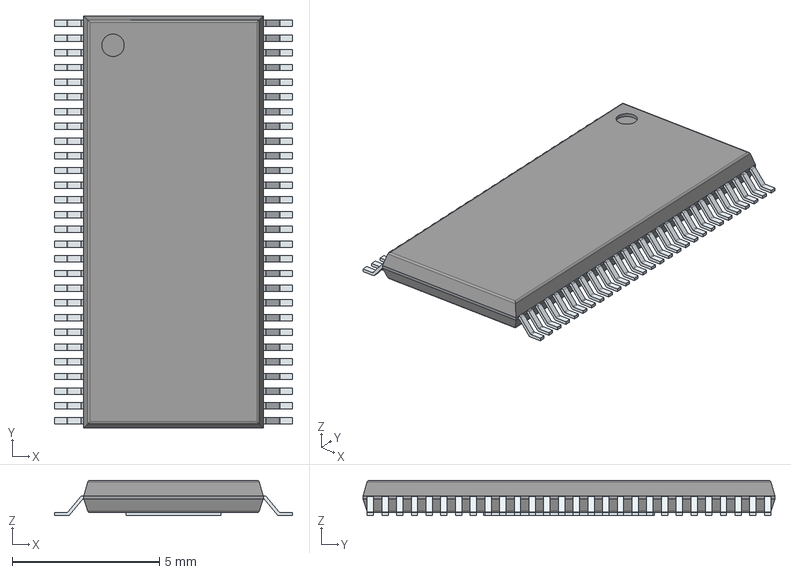
[picture p30: CAD file, 2019-08-06]
Models/Models_motor_control/LIB_DRV8302DCAR/DRV8302DCAR/3D/DRV8302DCAR.stp
8.10 x 14.0 x 1.20 mm
PinsArrayLR
ThermalPad
