goldstar971/Movin_on/Models/Models_motor_control/LIB_EEE-FT1H331AP/EEE-FT1H331AP/3D/EEE-FT1H331AP.stp

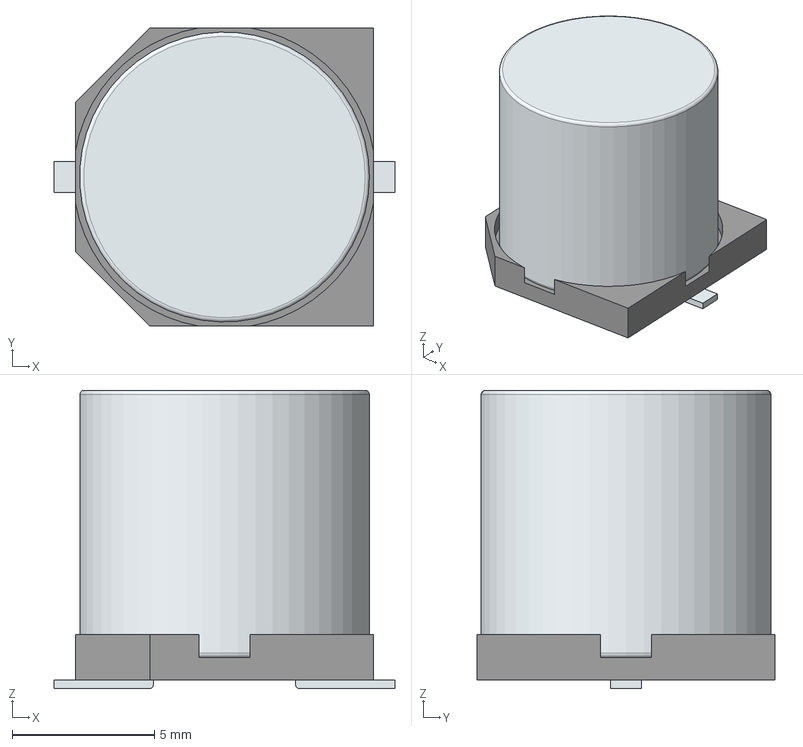
[picture p31: CAD file, 2019-08-06]
Models/Models_motor_control/LIB_EEE-FT1H331AP/EEE-FT1H331AP/3D/EEE-FT1H331AP.stp
12.0 x 10.5 x 10.5 mm
Base
Pin1Fillet
Pin2Fillet
