goldstar971/Movin_on/Models/Models_motor_control/LIB_ERA3AEB121V/ERA3AEB121V/3D/ERA3AEB121V.stp

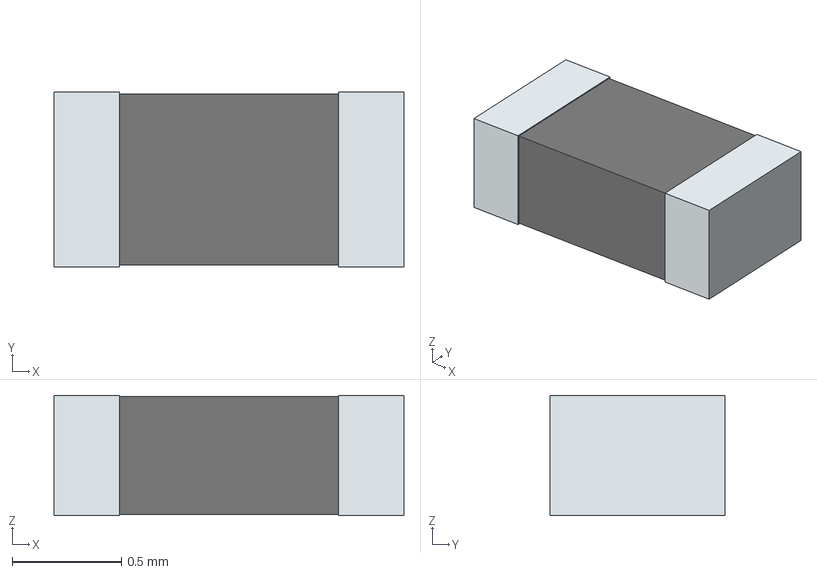
[picture p32: CAD file, 2019-08-06]
Models/Models_motor_control/LIB_ERA3AEB121V/ERA3AEB121V/3D/ERA3AEB121V.stp
1.60 x 0.8 x 0.55 mm
term1
term2
