goldstar971/Movin_on/Models/Models_motor_control/LIB_ERJ3EKF2201V/ERJ3EKF2201V/3D/ERJ3EKF2201V.stp

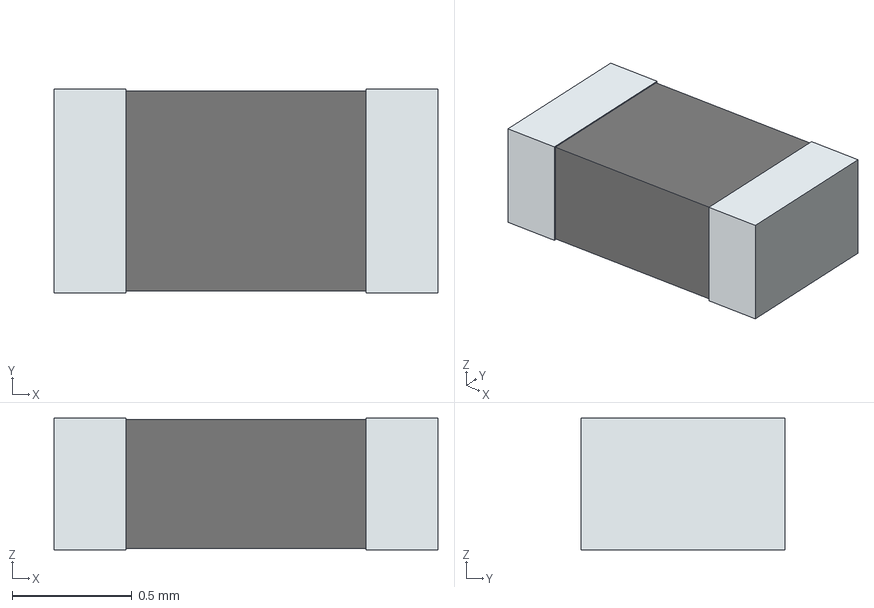
[picture p33: CAD file, 2019-08-06]
Models/Models_motor_control/LIB_ERJ3EKF2201V/ERJ3EKF2201V/3D/ERJ3EKF2201V.stp
1.60 x 0.85 x 0.55 mm
term1
term2
