goldstar971/Movin_on/Models/Models_motor_control/LIB_GRM033R61E224KE01D/GRM033R61E224KE01D/3D/GRM033R61E224KE01D.stp

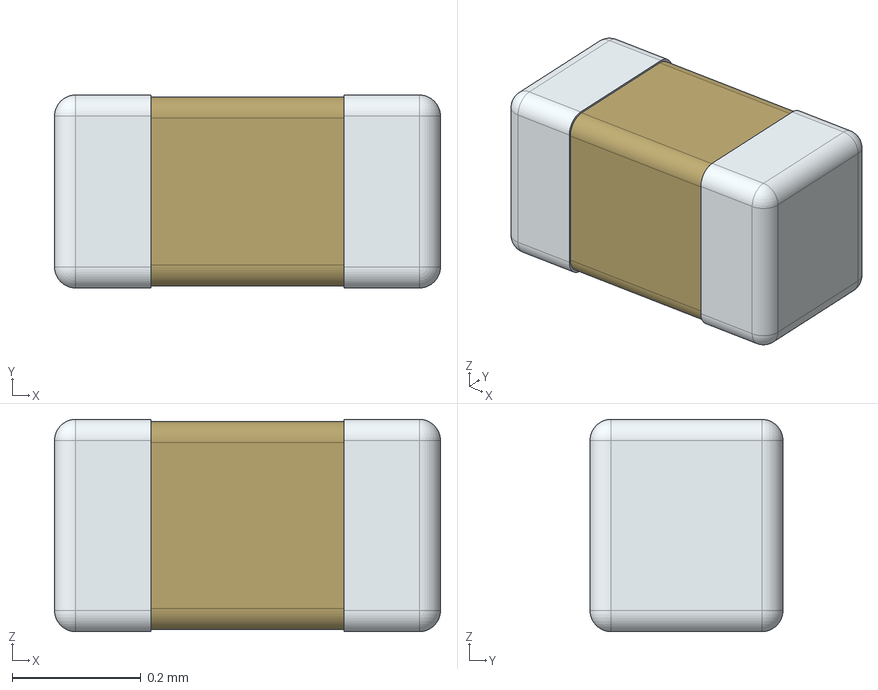
[picture p34: CAD file, 2019-11-14]
Models/Models_motor_control/LIB_GRM033R61E224KE01D/GRM033R61E224KE01D/3D/GRM033R61E224KE01D.stp
0.6 x 0.3 x 0.33 mm
