goldstar971/Movin_on/Models/Models_motor_control/LIB_SDR0805-220ML/SDR0805-220ML/3D/SDR0805-220ML.stp

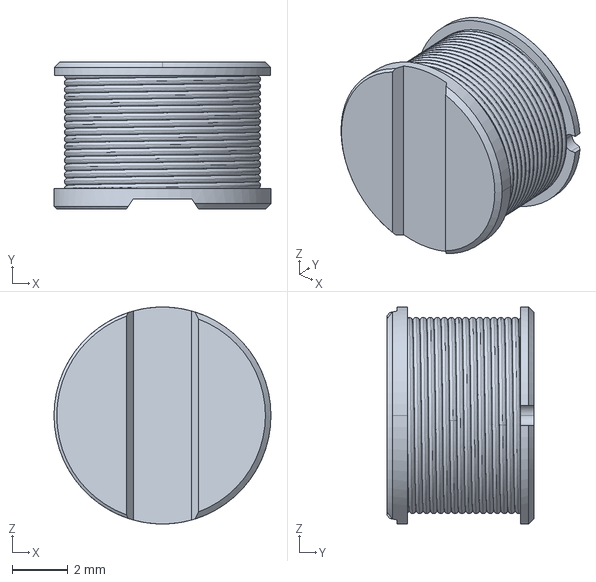
[picture p35: CAD file, 2019-08-06]
Models/Models_motor_control/LIB_SDR0805-220ML/SDR0805-220ML/3D/SDR0805-220ML.stp
7.80 x 5.30 x 7.80 mm
