goldstar971/Movin_on/Models/Models_motor_control/LIB_SMAJ5.0A/SMAJ5.0A/3D/SMAJ5.0A.stp

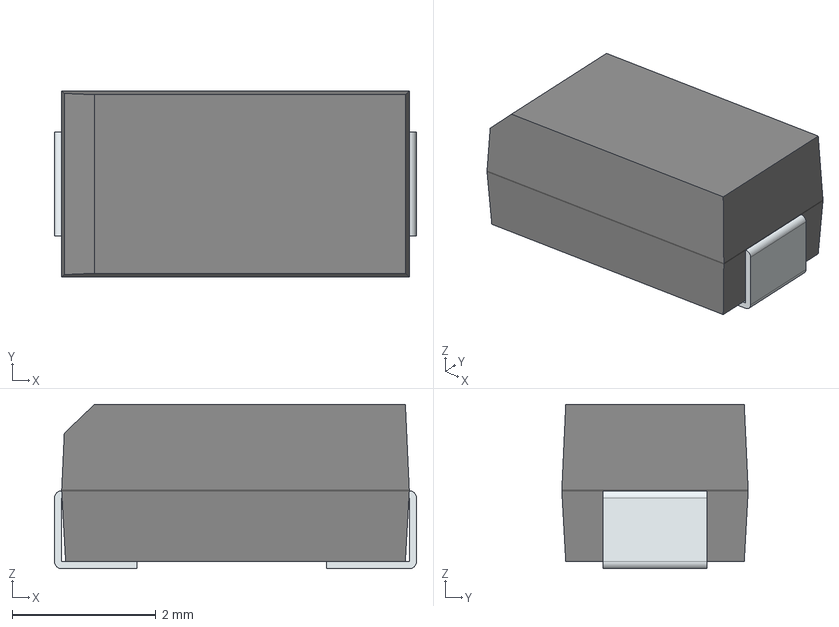
[picture p36: CAD file, 2019-10-25]
Models/Models_motor_control/LIB_SMAJ5.0A/SMAJ5.0A/3D/SMAJ5.0A.stp
5.04 x 2.60 x 2.29 mm
FilletPin1
FilletPin2
