goldstar971/Movin_on/Models/Models_motor_control/LIB_STM32F765VIT6/STM32F765VIT6/3D/STM32F765VIT6.stl

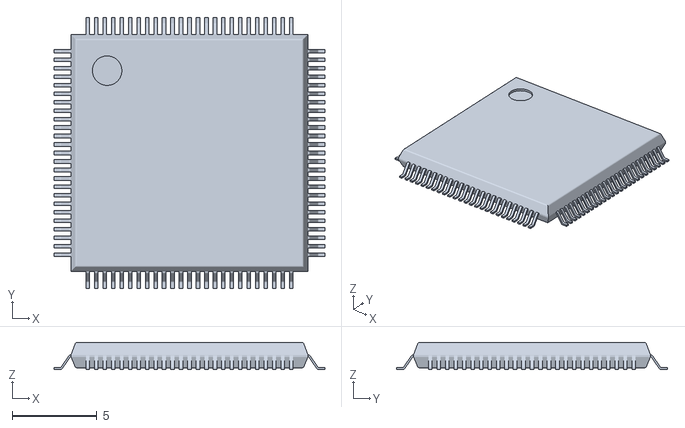
[picture p37: CAD file, 2019-08-06]
Models/Models_motor_control/LIB_STM32F765VIT6/STM32F765VIT6/3D/STM32F765VIT6.stl
16.0 x 16.0 x 1.60
