goldstar971/Movin_on/Models/Models_motor_control/LIB_UVR1H102MHD1TO/UVR1H102MHD1TO/3D/UVR1H102MHD1TO.stp

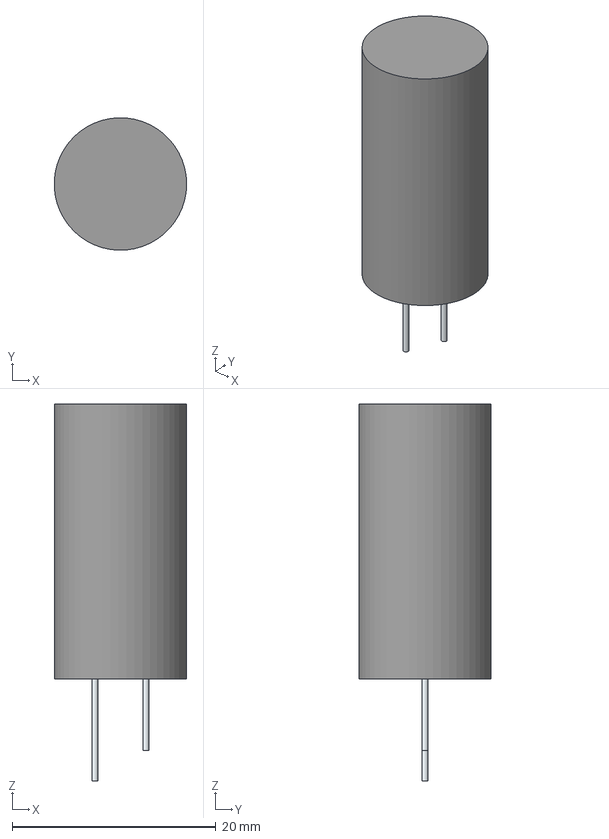
[picture p38: CAD file, 2019-08-06]
Models/Models_motor_control/LIB_UVR1H102MHD1TO/UVR1H102MHD1TO/3D/UVR1H102MHD1TO.stp
13.0 x 13.0 x 37.0 mm
SimpleBody
Pin1
Pin2
