goldstar971/Movin_on/Models/Acceleration_control_models/Kicad_3D/MCP4728A1T-E_UN.stp

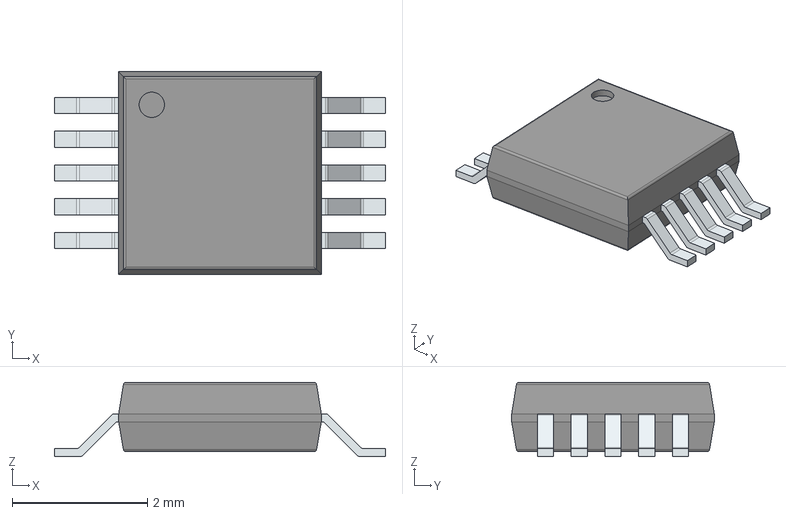
[picture p41: CAD file, 2019-09-30]
Models/Acceleration_control_models/Kicad_3D/MCP4728A1T-E_UN.stp
4.90 x 3.00 x 1.10 mm
PinsArrayLR
