goldstar971/Movin_on/Models/Models_motor_control/LIB_WSLP27261L000FEA/WSLP27261L000FEA/3D/_wslp2726-notched_3dmodel/WSLP2726 (Notched)/WSLP2726 (0.0003).step

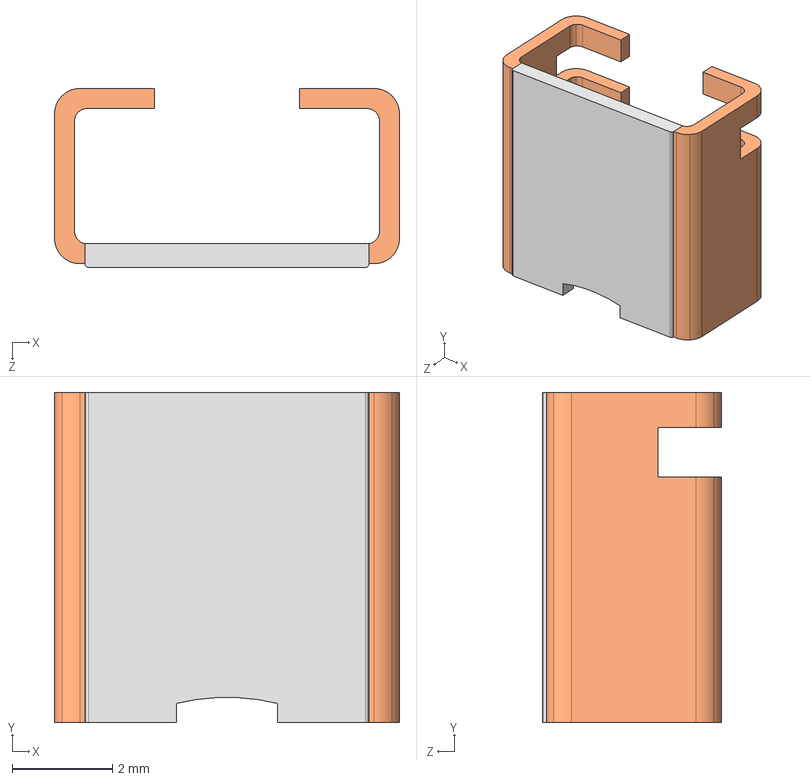
[picture p44: CAD file, 2019-08-06]
Models/Models_motor_control/LIB_WSLP27261L000FEA/WSLP27261L000FEA/3D/_wslp2726-notched_3dmodel/WSLP2726 (Notched)/WSLP2726 (0.0003).step
6.90 x 6.60 x 3.58 mm
