goldstar971/Movin_on/(list of files, cad)

Other CAD files:
Models/Acceleration_control_models/LIB_AS0805KKX7R0BB104/AS0805KKX7R0BB104/3D/AS0805KKX7R0BB104.stp
Models/Acceleration_control_models/LIB_GRM1555C1H470FA01J/GRM1555C1H470FA01J/3D/GRM1555C1H470FA01J.stp
Models/Acceleration_control_models/LIB_GRM155C80G106ME44D/GRM155C80G106ME44D/3D/GRM155C80G106ME44D.stp
Models/Acceleration_control_models/LIB_GRM155C81C105ME11J/GRM155C81C105ME11J/3D/GRM155C81C105ME11J.stp
Models/Acceleration_control_models/LIB_MCT0603PD2002DP500/MCT0603PD2002DP500/3D/MCT0603PD2002DP500.stp
Models/Acceleration_control_models/LIB_MCT0603PD4991DP500/MCT0603PD4991DP500/3D/MCT0603PD4991DP500.stp
Models/Acceleration_control_models/LIB_MCT0603PD4992DP500/MCT0603PD4992DP500/3D/MCT0603PD4992DP500.stp
Models/Models_motor_control/LIB_C0603C153J3GACTU/C0603C153J3GACTU/3D/C0603C153J3GACTU.stp
Models/Models_motor_control/LIB_CGA2B3X7R1E224K050BE/CGA2B3X7R1E224K050BE/3D/CGA2B3X7R1E224K050BE.stp
Models/Models_motor_control/LIB_CGA3E2X7R1H223K080AA/CGA3E2X7R1H223K080AA/3D/CGA3E2X7R1H223K080AA.stp
Models/Models_motor_control/LIB_ERJ3EKF3902V/ERJ3EKF3902V/3D/ERJ3EKF3902V.stp
Models/Models_motor_control/LIB_ERJ3RQF4R7V/ERJ3RQF4R7V/3D/ERJ3RQF4R7V.stp
Models/Models_motor_control/LIB_GCM155R71H472KA37D/GCM155R71H472KA37D/3D/GCM155R71H472KA37D.stp
Models/Models_motor_control/LIB_LTST-C191KGKT/LTST-C191KGKT/3D/C0603C221K5RACAUTO.stp
Models/Models_motor_control/LIB_LTST-C191KRKT/LTST-C191KRKT/3D/C0603C221K5RACAUTO.stp
Models/Models_motor_control/LIB_RK73H1JTTD1000F/RK73H1JTTD1000F/3D/RK73H1JTTD1000F.stp
Models/Models_motor_control/LIB_RK73H1JTTD1002F/RK73H1JTTD1002F/3D/RK73H1JTTD1002F.stp
Models/Models_motor_control/LIB_RK73H1JTTD1004F/RK73H1JTTD1004F/3D/RK73H1JTTD1004F.stp
Models/Models_motor_control/LIB_RK73H1JTTD1502F/RK73H1JTTD1502F/3D/RK73H1JTTD1502F.stp
Models/Models_motor_control/LIB_RK73H1JTTD1802F/RK73H1JTTD1802F/3D/RK73H1JTTD1802F.stp
Models/Models_motor_control/LIB_RK73H1JTTD2201F/RK73H1JTTD2201F/3D/RK73H1JTTD2201F.stp
Models/Models_motor_control/LIB_RK73H1JTTD2203F/RK73H1JTTD2203F/3D/RK73H1JTTD2203F.stp
Models/Models_motor_control/LIB_RK73H1JTTD3301F/RK73H1JTTD3301F/3D/RK73H1JTTD3301F.stp
Models/Models_motor_control/LIB_RK73H1JTTD4R70F/RK73H1JTTD4R70F/3D/RK73H1JTTD4R70F.stp
Models/Acceleration_control_models/Kicad_3D/MCT0603PD2002DP500.stp
Models/Acceleration_control_models/Kicad_3D/GRM155C80G106ME44D.stp
Models/Acceleration_control_models/Kicad_3D/MCT0603PD4991DP500.stp
Models/Models_motor_control/LIB_WSLP27261L000FEA/WSLP27261L000FEA/3D/_wslp2726-notched_3dmodel/WSLP2726 (Notched)/WSLP2726 (0.003, 0.004, 0.005).step
Models/Acceleration_control_models/Kicad_3D/GRM1555C1H470FA01J.stp
Models/Acceleration_control_models/Kicad_3D/MCT0603PD4992DP500.stp
Models/Acceleration_control_models/Kicad_3D/GRM155C81C105ME11J.stp
Models/Acceleration_control_models/Kicad_3D/AS0805KKX7R0BB104.stp
Models/Acceleration_control_models/GRM155R62A104KE14D/3D/GRM155R62A104KE14D.stl
Models/Acceleration_control_models/GRM155R62A104KE14D/Allegro/capc1005x55n.psm
Models/Acceleration_control_models/GRM155R62A104KE14D/DEHDL/grm155r62a104ke14d/chips/chips.prt
Models/Acceleration_control_models/GRM21BR61E106KA73K/3D/GRM21BR61E106KA73K.stl
Models/Acceleration_control_models/GRM21BR61E106KA73K/Allegro/capc2012x145n.psm
Models/Acceleration_control_models/GRM21BR61E106KA73K/DEHDL/grm21br61e106ka73k/chips/chips.prt
Models/Acceleration_control_models/LIB_AS0805KKX7R0BB104/AS0805KKX7R0BB104/3D/AS0805KKX7R0BB104.stl
Models/Acceleration_control_models/LIB_AS0805KKX7R0BB104/AS0805KKX7R0BB104/Allegro/capc2012x145n.psm
Models/Acceleration_control_models/LIB_AS0805KKX7R0BB104/AS0805KKX7R0BB104/DEHDL/AS0805KKX7R0BB104/chips/chips.prt
Models/Acceleration_control_models/LIB_C3216X7R1H225K160AE/C3216X7R1H225K160AE/3D/C3216X7R1H225K160AE.stl
Models/Acceleration_control_models/LIB_C3216X7R1H225K160AE/C3216X7R1H225K160AE/Allegro/capc3216x180n.psm
Models/Acceleration_control_models/LIB_C3216X7R1H225K160AE/C3216X7R1H225K160AE/DEHDL/C3216X7R1H225K160AE/chips/chips.prt
Models/Acceleration_control_models/LIB_CGA6M3X7S2A475K200AB/CGA6M3X7S2A475K200AB/3D/CGA6M3X7S2A475K200AB.stl
Models/Acceleration_control_models/LIB_CGA6M3X7S2A475K200AB/CGA6M3X7S2A475K200AB/Allegro/capc3225x200n.psm
Models/Acceleration_control_models/LIB_CGA6M3X7S2A475K200AB/CGA6M3X7S2A475K200AB/DEHDL/CGA6M3X7S2A475K200AB/chips/chips.prt
Models/Acceleration_control_models/LIB_GRM1555C1H470FA01J/GRM1555C1H470FA01J/Allegro/capc1005x55n.psm
Models/Acceleration_control_models/LIB_GRM1555C1H470FA01J/GRM1555C1H470FA01J/DEHDL/grm1555c1h470fa01j/chips/chips.prt
Models/Acceleration_control_models/LIB_GRM155C80G106ME44D/GRM155C80G106ME44D/Allegro/capc1005x55n.psm
Models/Acceleration_control_models/LIB_GRM155C80G106ME44D/GRM155C80G106ME44D/DEHDL/grm155c80g106me44d/chips/chips.prt
Models/Acceleration_control_models/LIB_GRM155C81C105ME11J/GRM155C81C105ME11J/Allegro/capc1005x55n.psm
Models/Acceleration_control_models/LIB_GRM155C81C105ME11J/GRM155C81C105ME11J/DEHDL/GRM155C81C105ME11J/chips/chips.prt
Models/Acceleration_control_models/LIB_LIS2DTW12TR/LIS2DTW12TR/3D/LIS2DTW12TR.stl
Models/Acceleration_control_models/LIB_LIS2DTW12TR/LIS2DTW12TR/Allegro/iis2mdctr.psm
Models/Acceleration_control_models/LIB_LIS2DTW12TR/LIS2DTW12TR/DEHDL/lis2dtw12tr/chips/chips.prt
Models/Acceleration_control_models/LIB_MAX5815BAUD+/MAX5815BAUD+/3D/MAX5815BAUD+.stl
Models/Acceleration_control_models/LIB_MAX5815BAUD+/MAX5815BAUD+/Allegro/sop65p640x110-14n.psm
Models/Acceleration_control_models/LIB_MAX5815BAUD+/MAX5815BAUD+/DEHDL/max5815baud_/chips/chips.prt
Models/Acceleration_control_models/LIB_MCP6054-E_SL/MCP6054-E_SL/3D/MCP6054-E_SL.stl
Models/Acceleration_control_models/LIB_MCP6054-E_SL/MCP6054-E_SL/Allegro/soic127p600x175-14n.psm
Models/Acceleration_control_models/LIB_MCP6054-E_SL/MCP6054-E_SL/DEHDL/mcp6054_e_sl/chips/chips.prt
Models/Acceleration_control_models/LIB_MCT0603PD1003DP500/MCT0603PD1003DP500/3D/MCT0603PD1003DP500.stl
Models/Acceleration_control_models/LIB_MCT0603PD1003DP500/MCT0603PD1003DP500/Allegro/resc1608x55n.psm
Models/Acceleration_control_models/LIB_MCT0603PD1003DP500/MCT0603PD1003DP500/DEHDL/mct0603pd1003dp500/chips/chips.prt
Models/Acceleration_control_models/LIB_MCT0603PD2002DP500/MCT0603PD2002DP500/3D/MCT0603PD2002DP500.stl
Models/Acceleration_control_models/LIB_MCT0603PD2002DP500/MCT0603PD2002DP500/Allegro/resc1608x55n.psm
Models/Acceleration_control_models/LIB_MCT0603PD2002DP500/MCT0603PD2002DP500/DEHDL/mct0603pd2002dp500/chips/chips.prt
Models/Acceleration_control_models/LIB_MCT0603PD4991DP500/MCT0603PD4991DP500/3D/MCT0603PD4991DP500.stl
Models/Acceleration_control_models/LIB_MCT0603PD4991DP500/MCT0603PD4991DP500/Allegro/resc1608x55n.psm
Models/Acceleration_control_models/LIB_MCT0603PD4991DP500/MCT0603PD4991DP500/DEHDL/mct0603pd4991dp500/chips/chips.prt
Models/Acceleration_control_models/LIB_MCT0603PD4992DP500/MCT0603PD4992DP500/3D/MCT0603PD4992DP500.stl
Models/Acceleration_control_models/LIB_MCT0603PD4992DP500/MCT0603PD4992DP500/Allegro/resc1608x55n.psm
Models/Acceleration_control_models/LIB_MCT0603PD4992DP500/MCT0603PD4992DP500/DEHDL/mct0603pd4992dp500/chips/chips.prt
Models/Acceleration_control_models/LIB_SM04B-PASS-TBT(LF)(SN)/SM04B-PASS-TBT(LF)(SN)/Allegro/sm04b-pass-tbt.psm
Models/Acceleration_control_models/LIB_SM04B-PASS-TBT(LF)(SN)/SM04B-PASS-TBT(LF)(SN)/DEHDL/SM04B_PASS_TBT(LF)(SN)/chips/chips.prt
Models/Acceleration_control_models/LIB_SM05B-PASS-TBT(LF)(SN)/SM05B-PASS-TBT(LF)(SN)/Allegro/sm05bpasstbtlfsn.psm
Models/Acceleration_control_models/LIB_SM05B-PASS-TBT(LF)(SN)/SM05B-PASS-TBT(LF)(SN)/DEHDL/SM05B_PASS_TBT(LF)(SN)/chips/chips.prt
Models/Acceleration_control_models/LIB_SN65HVD232DR/SN65HVD232DR/3D/SN65HVD232DR.stl
Models/Acceleration_control_models/LIB_SN65HVD232DR/SN65HVD232DR/Allegro/soic127p600x175-8n.psm
Models/Acceleration_control_models/LIB_SN65HVD232DR/SN65HVD232DR/DEHDL/SN65HVD232DR/chips/chips.prt
Models/Acceleration_control_models/LIB_STM32F205RBT6/STM32F205RBT6/Allegro/qfp50p1200x1200x160-64n.psm
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
