goldstar971/Movin_on/kicad_files/PCB schematics and other design stuff/FSR/DAC_calibration_test.png

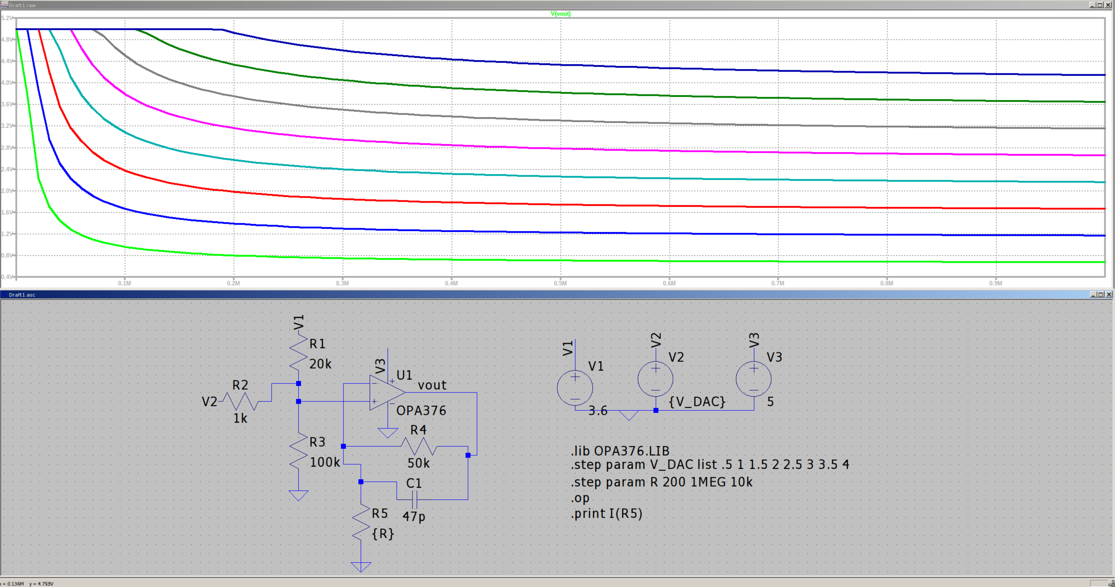
kicad_files/PCB schematics and other design stuff/FSR/DAC_calibration_test.png
