goldstar971/Movin_on/kicad_files/PCB schematics and other design stuff/FSR/force_sensor_calibration_circuit_schematic.png

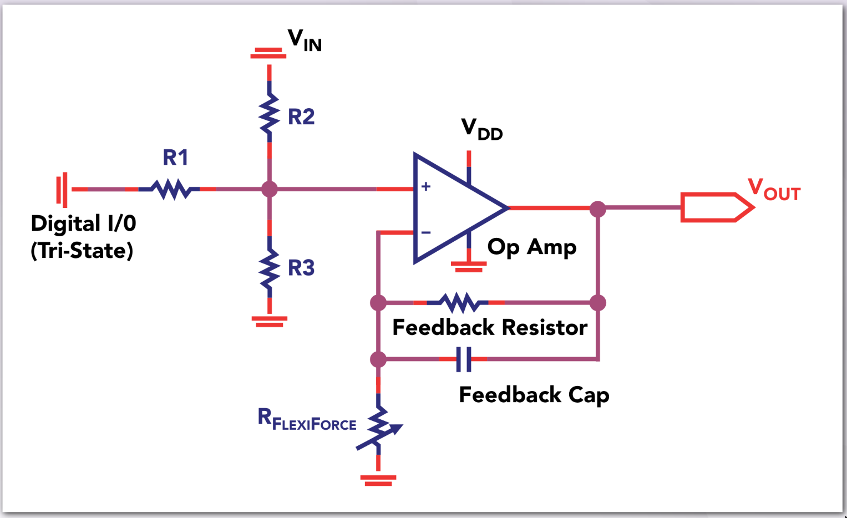
kicad_files/PCB schematics and other design stuff/FSR/force_sensor_calibration_circuit_schematic.png
