goldstar971/Movin_on/kicad_files/PCB schematics and other design stuff/battery_pack_and_bms/battery_pack_and_bms.pdf

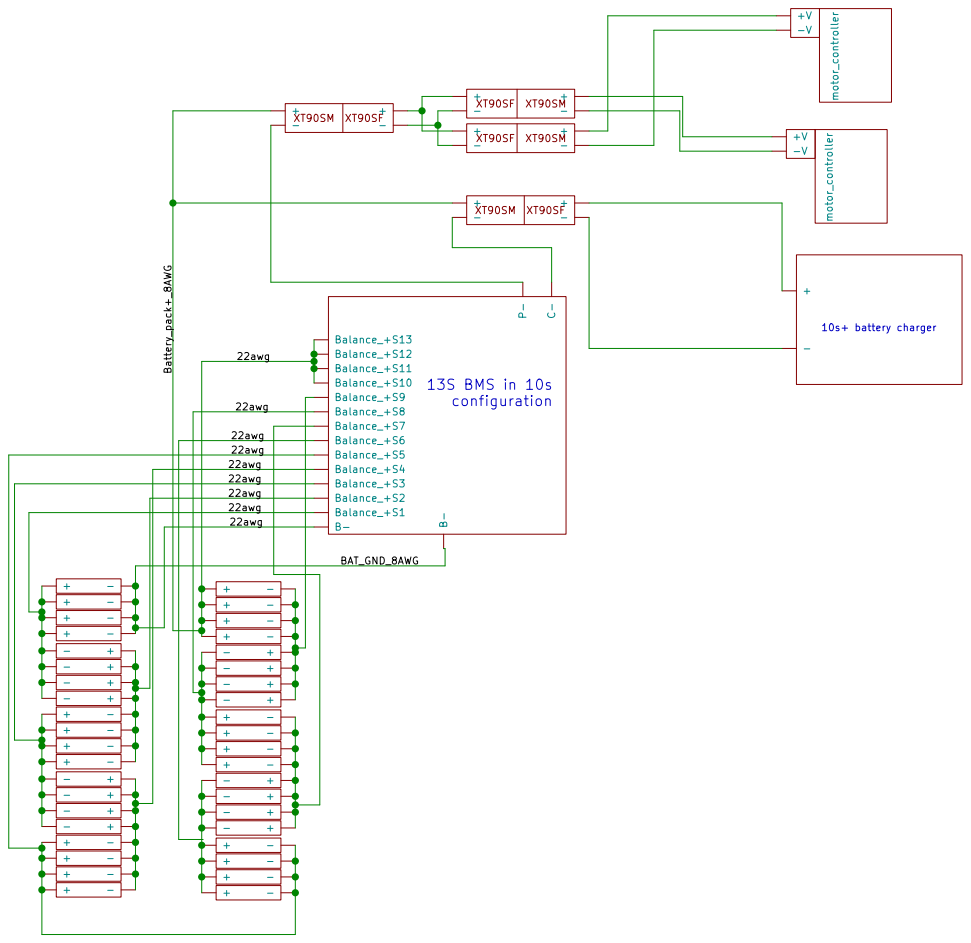
[picture p47: page 1]

22awg
