goldstar971/Movin_on/kicad_files/Forward_acceleration_board/Forward_acceleration_board.kicad_pcb

## KiCad design kicad_files/Forward_acceleration_board/Forward_acceleration_board.kicad_pcb (2019-11-22)

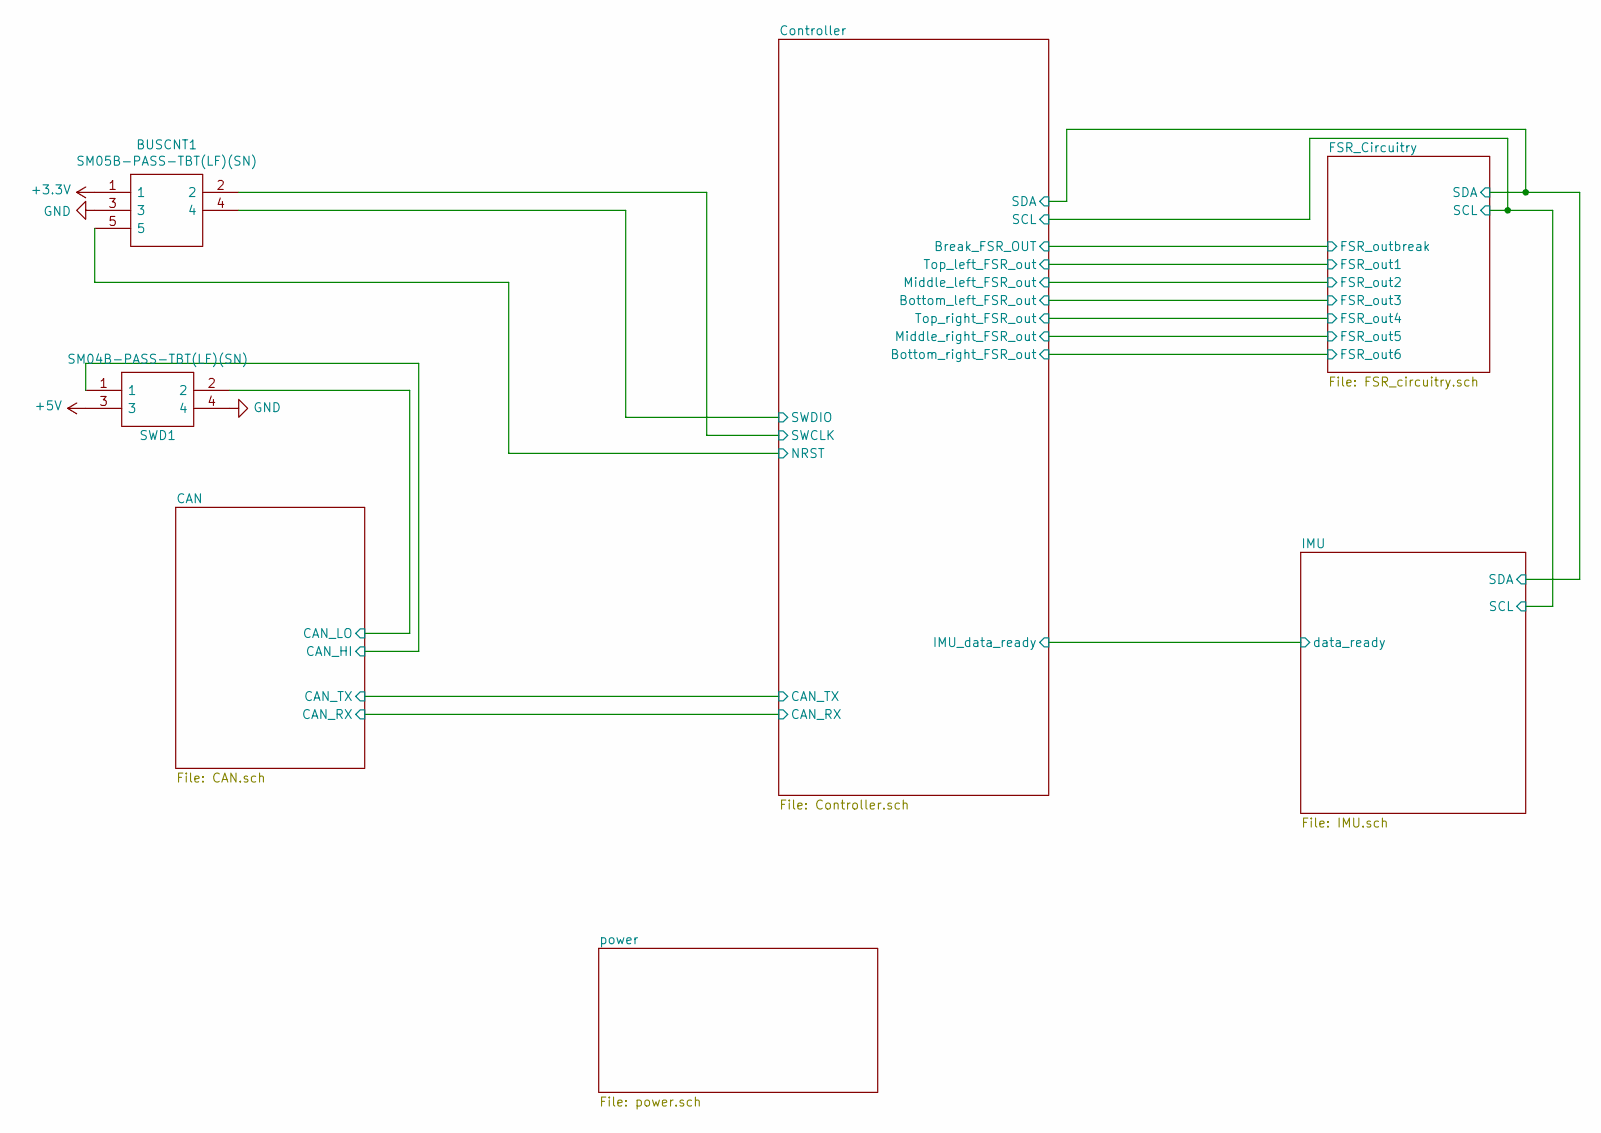
[picture p55: schematic Forward_acceleration_board.sch]

Parts:
BUSCNT1: SM05B-PASS-TBT(LF)(SN); SM05BPASSTBTLFSN; Manufacturer_Part_Number SM05B-PASS-TBT(LF)(SN)
SWD1: SM04B-PASS-TBT(LF)(SN); SM04B-PASS-TBT; Manufacturer_Part_Number SM04B-PASS-TBT(LF)(SN)

Connections:
+3V3: BUSCNT1.1; also elsewhere on the board
+5V: SWD1.3; also elsewhere on the board
/CAN/CAN_HI: SWD1.1; also elsewhere on the board
/CAN/CAN_LO: SWD1.2; also elsewhere on the board
/Controller/NRST: BUSCNT1.5; also elsewhere on the board
/Controller/SWCLK: BUSCNT1.2; also elsewhere on the board
/Controller/SWDIO: BUSCNT1.4; also elsewhere on the board
GND: BUSCNT1.3, SWD1.4; also elsewhere on the board
