goldstar971/Movin_on/kicad_files/Forward_acceleration_board/Forward_acceleration_board.kicad_pcb

## KiCad design kicad_files/Forward_acceleration_board/Forward_acceleration_board.kicad_pcb (continued)

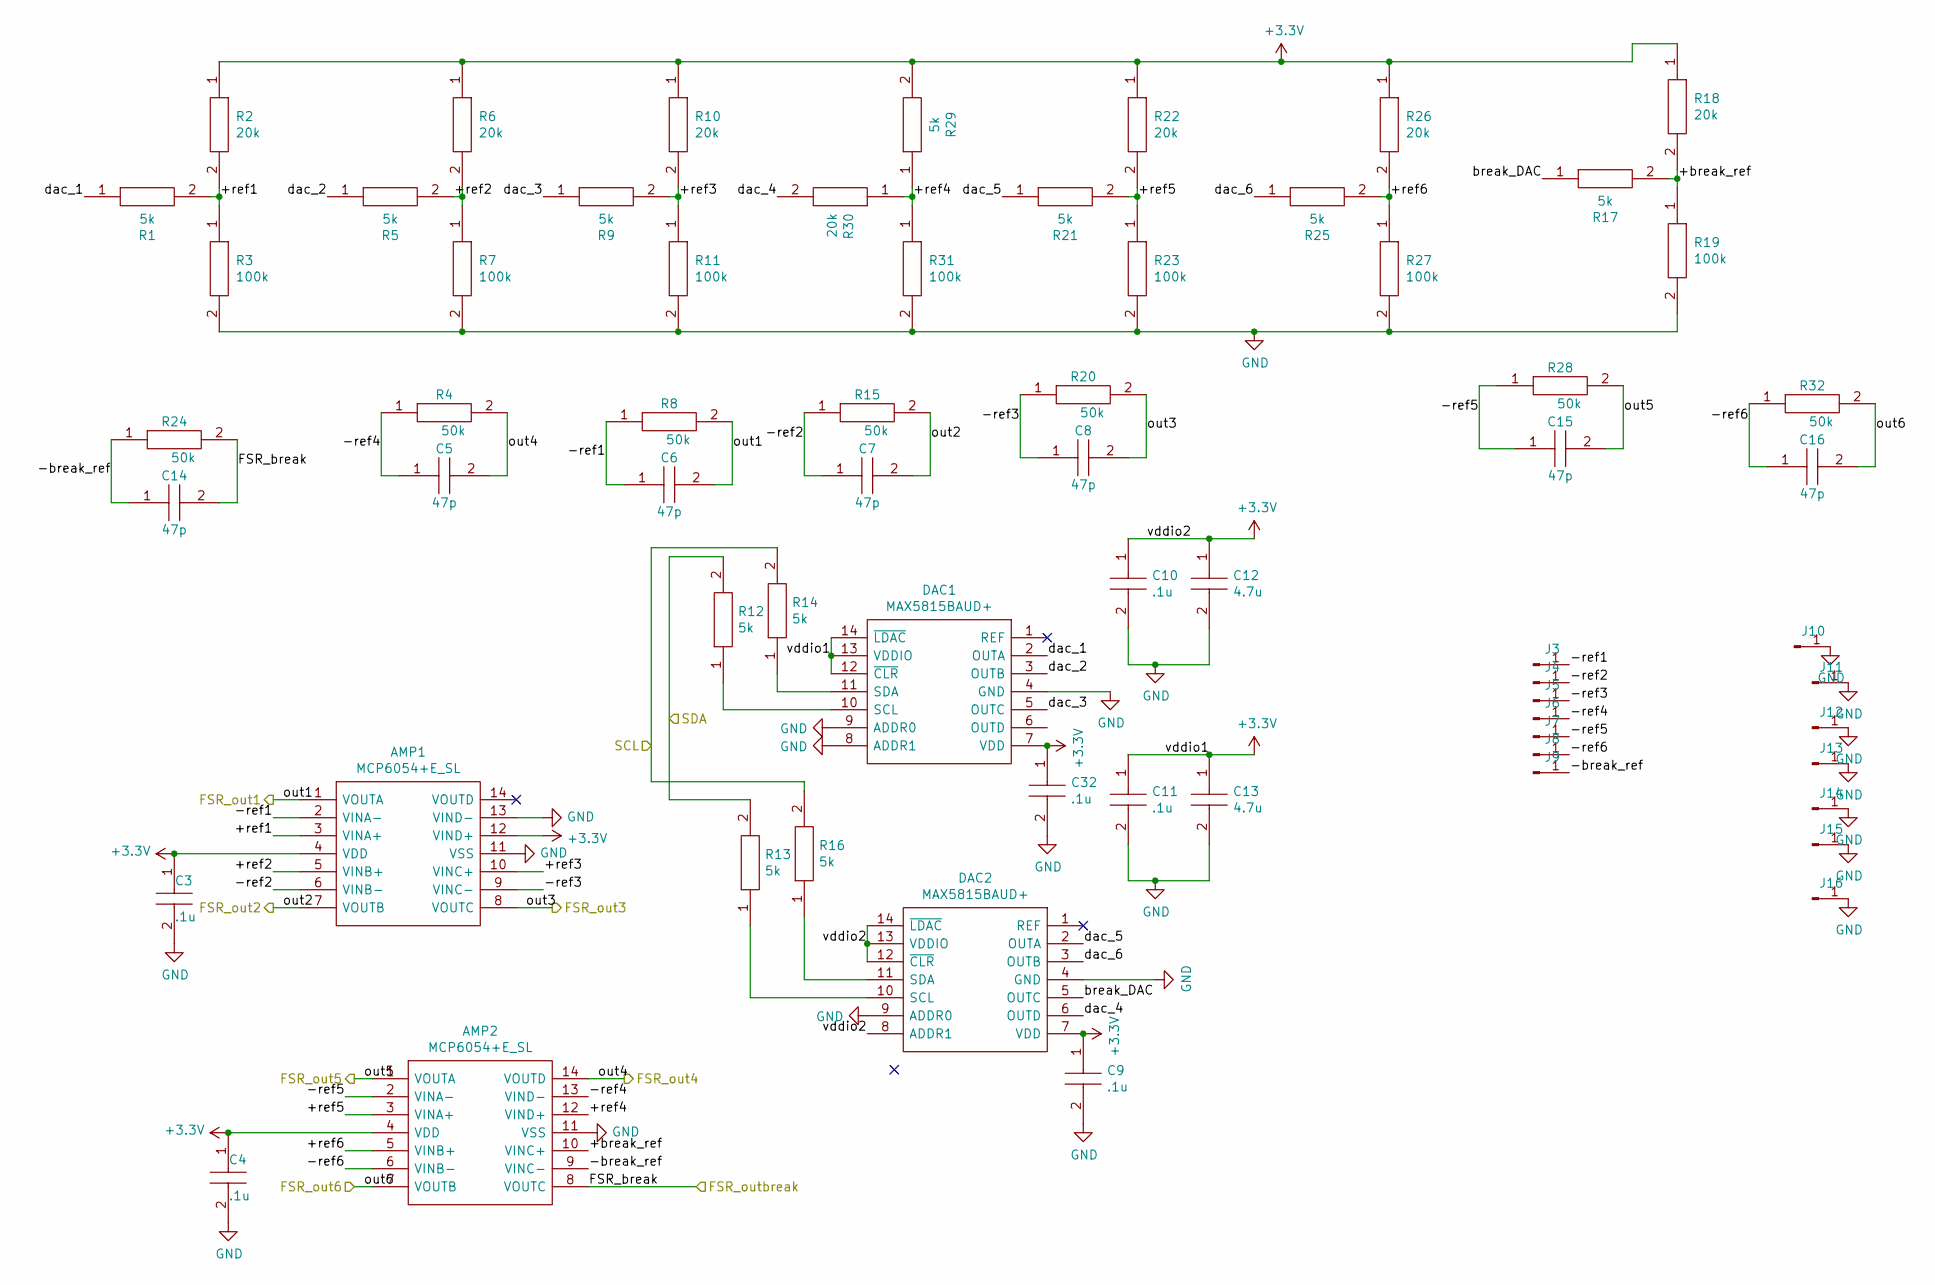
[picture p56: schematic FSR_circuitry.sch]

Parts:
AMP1, AMP2: MCP6054+E_SL; SOIC127P600X175-14N; Mouser Part Number 579-MCP6054-E/SL
C3, C4, C9, C10, C11, C32: .1u; CAPC2012X145N; Manufacturer_Part_Number AS0805KKX7R0BB104; Mouser Part Number 603-AS0805KKX70BB104
C5, C6, C7, C8, C14, C15, C16: 47p; CAPC1005X55N; Mouser Part Number 81-GRM1555C1H470FA1J
C12, C13: 4.7u; CAPC3225X200N; Manufacturer_Part_Number CGA6M3X7S2A475K200AB; Mouser Part Number 810-CGA6M3X7S2A475K
DAC1, DAC2: MAX5815BAUD+; SOP65P640X110-14N; Mouser Part Number 700-MAX5815BAUD+
J3, J4, J5, J6, J7, J8, J9, J10, J11, J12, J13, J14, J15, J16: Conn_01x01_Male; SolderWirePad_1x01_SMD_1.27x2.54mm
R1, R5, R9, R12, R13, R14, R16, R17, R21, R25, R29: 5k; RESC1608X55N; Mouser Part Number 594-MCT0603PD4991DP5
R2, R6, R10, R18, R22, R26, R30: 20k; RESC1608X55N; Mouser Part Number 594-MCT0603PD2002DP5
R3, R7, R11, R19, R23, R27, R31: 100k; RESC1608X55N; Mouser Part Number 594-MCT0603PD1003DP5
R4, R8, R15, R20, R24, R28, R32: 50k; RESC1608X55N; Mouser Part Number 594-MCT0603PD4992DP5

Connections:
+3V3: AMP1.4 (VDD), AMP1.12 (VIND+), AMP2.4 (VDD), C3.1, C4.1, C9.1, C10.1, C11.1, C12.1, C13.1, C32.1, DAC1.7 (VDD), DAC1.12 (~CLR), DAC1.13 (VDDIO), DAC1.14 (~LDAC), DAC2.7 (VDD), DAC2.8 (ADDR1), DAC2.12 (~CLR), DAC2.13 (VDDIO), DAC2.14 (~LDAC), R2.1, R6.1, R10.1, R18.1, R22.1, R26.1, R29.2; also elsewhere on the board
/Controller/Bottom_left_FSR_out: AMP1.8 (VOUTC), C8.2, R20.2; also elsewhere on the board
/Controller/Bottom_right_FSR_out: AMP2.7 (VOUTB), C16.2, R32.2; also elsewhere on the board
/Controller/Break_FSR_OUT: AMP2.8 (VOUTC), C14.2, R24.2; also elsewhere on the board
/Controller/SCL: R14.2, R16.2; also elsewhere on the board
/Controller/SDA: R12.2, R13.2; also elsewhere on the board
/FSR_Circuitry/+break_ref: AMP2.10 (VINC+), R17.2, R18.2, R19.1
/FSR_Circuitry/+ref1: AMP1.3 (VINA+), R1.2, R2.2, R3.1
/FSR_Circuitry/+ref2: AMP1.5 (VINB+), R5.2, R6.2, R7.1
/FSR_Circuitry/+ref3: AMP1.10 (VINC+), R9.2, R10.2, R11.1
/FSR_Circuitry/+ref4: AMP2.12 (VIND+), R29.1, R30.1, R31.1
/FSR_Circuitry/+ref5: AMP2.3 (VINA+), R21.2, R22.2, R23.1
/FSR_Circuitry/+ref6: AMP2.5 (VINB+), R25.2, R26.2, R27.1
/FSR_Circuitry/-break_ref: AMP2.9 (VINC-), C14.1, J9.1, R24.1
/FSR_Circuitry/-ref1: AMP1.2 (VINA-), C6.1, J3.1, R8.1
/FSR_Circuitry/-ref2: AMP1.6 (VINB-), C7.1, J4.1, R15.1
/FSR_Circuitry/-ref3: AMP1.9 (VINC-), C8.1, J5.1, R20.1
/FSR_Circuitry/-ref4: AMP2.13 (VIND-), C5.1, J6.1, R4.1
/FSR_Circuitry/-ref5: AMP2.2 (VINA-), C15.1, J7.1, R28.1
/FSR_Circuitry/-ref6: AMP2.6 (VINB-), C16.1, J8.1, R32.1
/FSR_Circuitry/FSR_out1: AMP1.1 (VOUTA), C6.2, R8.2; also elsewhere on the board
/FSR_Circuitry/FSR_out2: AMP1.7 (VOUTB), C7.2, R15.2; also elsewhere on the board
/FSR_Circuitry/FSR_out4: AMP2.14 (VOUTD), C5.2, R4.2; also elsewhere on the board
/FSR_Circuitry/FSR_out5: AMP2.1 (VOUTA), C15.2, R28.2; also elsewhere on the board
/FSR_Circuitry/break_DAC: DAC2.5 (OUTC), R17.1
/FSR_Circuitry/dac_1: DAC1.2 (OUTA), R1.1
/FSR_Circuitry/dac_2: DAC1.3 (OUTB), R5.1
/FSR_Circuitry/dac_3: DAC1.5 (OUTC), R9.1
/FSR_Circuitry/dac_4: DAC2.6 (OUTD), R30.2
/FSR_Circuitry/dac_5: DAC2.2 (OUTA), R21.1
/FSR_Circuitry/dac_6: DAC2.3 (OUTB), R25.1
GND: AMP1.11 (VSS), AMP1.13 (VIND-), AMP2.11 (VSS), C3.2, C4.2, C9.2, C10.2, C11.2, C12.2, C13.2, C32.2, DAC1.4 (GND), DAC1.8 (ADDR1), DAC1.9 (ADDR0), DAC2.4 (GND), DAC2.9 (ADDR0), J10.1, J11.1, J12.1, J13.1, J14.1, J15.1, J16.1, R3.2, R7.2, R11.2, R19.2, R23.2, R27.2, R31.2; also elsewhere on the board
unnamed: DAC1.10 (SCL), R12.1
unnamed: DAC1.11 (SDA), R14.1
unnamed: DAC2.10 (SCL), R13.1
unnamed: DAC2.11 (SDA), R16.1

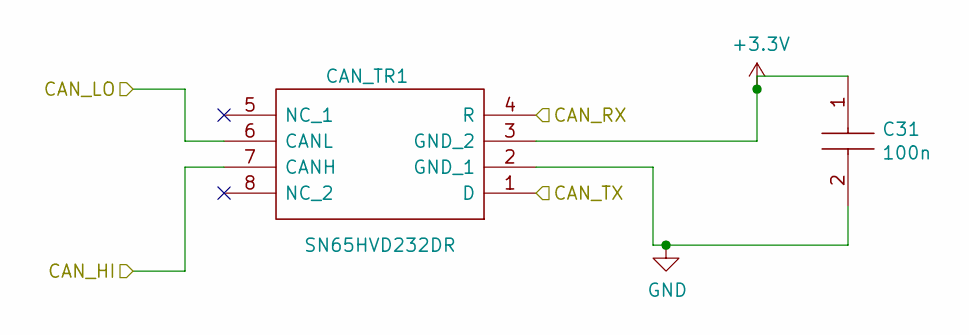
[picture p57: schematic CAN.sch]

Parts:
C31: 100n; CAPC2012X145N; Manufacturer_Part_Number AS0805KKX7R0BB104; Mouser Part Number 603-AS0805KKX70BB104
CAN_TR1: SN65HVD232DR; SOIC127P600X175-8N; Manufacturer_Part_Number SN65HVD232DR; Mouser Part Number 595-SN65HVD232DR

Connections:
+3V3: C31.1, CAN_TR1.3 (GND_2); also elsewhere on the board
/CAN/CAN_HI: CAN_TR1.7 (CANH); also elsewhere on the board
/CAN/CAN_LO: CAN_TR1.6 (CANL); also elsewhere on the board
/CAN/CAN_RX: CAN_TR1.4 (R); also elsewhere on the board
/CAN/CAN_TX: CAN_TR1.1 (D); also elsewhere on the board
GND: C31.2, CAN_TR1.2 (GND_1); also elsewhere on the board

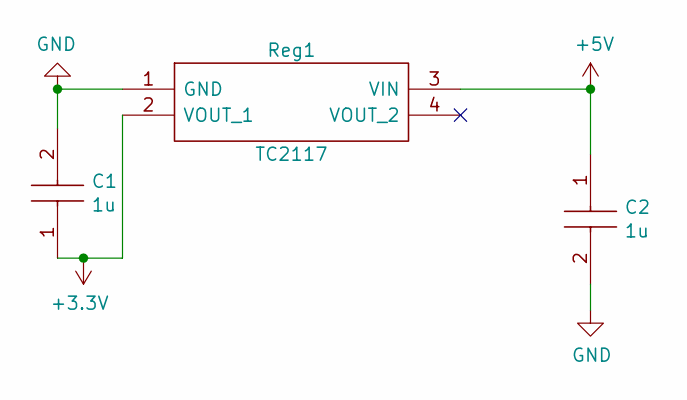
[picture p58: schematic power.sch]

Parts:
C1, C2: 1u; CAPC1005X55N; Manufacturer_Part_Number GRM155C81C105ME11J; Mouser Part Number 81-GRM155C81C105ME1J
Reg1: TC2117; SOT230P700X180-4N; Manufacturer_Part_Number TC2117-3.3VDBTR; Mouser Part Number 579-TC2117-3.3VDBTR

Connections:
+3V3: C1.1, Reg1.2 (VOUT_1); also elsewhere on the board
+5V: C2.1, Reg1.3 (VIN); also elsewhere on the board
GND: C1.2, C2.2, Reg1.1 (GND); also elsewhere on the board

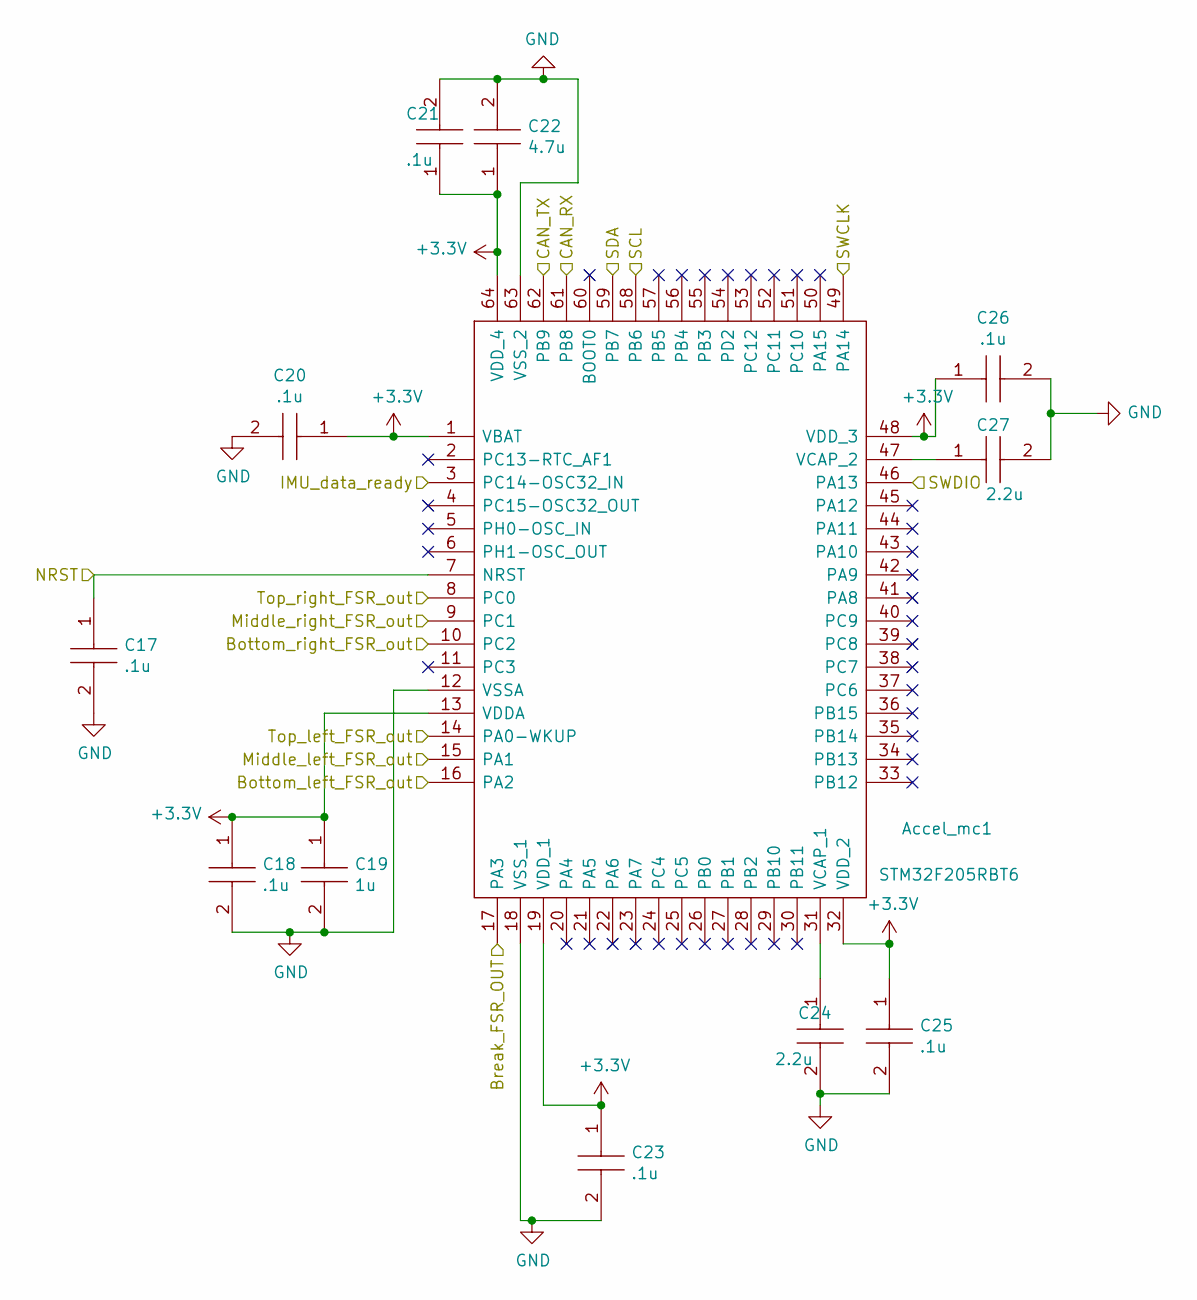
[picture p59: schematic Controller.sch]

Parts:
Accel_mc1: STM32F205RBT6; QFP50P1200X1200X160-64N; Mouser Part Number 511-STM32F205RBT6
C17, C18, C20, C21, C23, C25, C26: .1u; CAPC2012X145N; Manufacturer_Part_Number AS0805KKX7R0BB104; Mouser Part Number 603-AS0805KKX70BB104
C19: 1u; CAPC1005X55N; Manufacturer_Part_Number GRM155C81C105ME11J; Mouser Part Number 81-GRM155C81C105ME1J
C22: 4.7u; CAPC3225X200N; Manufacturer_Part_Number CGA6M3X7S2A475K200AB; Mouser Part Number 810-CGA6M3X7S2A475K
C24, C27: 2.2u; CAPC3216X180N; Manufacturer_Part_Number C3216X7R1H225K160AE; Mouser Part Number 810-C3216X7R1H225KST

Connections:
+3V3: Accel_mc1.1 (VBAT), Accel_mc1.13 (VDDA), Accel_mc1.19 (VDD_1), Accel_mc1.32 (VDD_2), Accel_mc1.48 (VDD_3), Accel_mc1.64 (VDD_4), C18.1, C19.1, C20.1, C21.1, C22.1, C23.1, C25.1, C26.1; also elsewhere on the board
/CAN/CAN_RX: Accel_mc1.61 (PB8); also elsewhere on the board
/CAN/CAN_TX: Accel_mc1.62 (PB9); also elsewhere on the board
/Controller/Bottom_left_FSR_out: Accel_mc1.16 (PA2); also elsewhere on the board
/Controller/Bottom_right_FSR_out: Accel_mc1.10 (PC2); also elsewhere on the board
/Controller/Break_FSR_OUT: Accel_mc1.17 (PA3); also elsewhere on the board
/Controller/IMU_data_ready: Accel_mc1.3 (PC14-OSC32_IN); also elsewhere on the board
/Controller/NRST: Accel_mc1.7 (NRST), C17.1; also elsewhere on the board
/Controller/SCL: Accel_mc1.58 (PB6); also elsewhere on the board
/Controller/SDA: Accel_mc1.59 (PB7); also elsewhere on the board
/Controller/SWCLK: Accel_mc1.49 (PA14); also elsewhere on the board
/Controller/SWDIO: Accel_mc1.46 (PA13); also elsewhere on the board
/FSR_Circuitry/FSR_out1: Accel_mc1.14 (PA0-WKUP); also elsewhere on the board
/FSR_Circuitry/FSR_out2: Accel_mc1.15 (PA1); also elsewhere on the board
/FSR_Circuitry/FSR_out4: Accel_mc1.8 (PC0); also elsewhere on the board
/FSR_Circuitry/FSR_out5: Accel_mc1.9 (PC1); also elsewhere on the board
GND: Accel_mc1.12 (VSSA), Accel_mc1.18 (VSS_1), Accel_mc1.63 (VSS_2), C17.2, C18.2, C19.2, C20.2, C21.2, C22.2, C23.2, C24.2, C25.2, C26.2, C27.2; also elsewhere on the board
unnamed: Accel_mc1.31 (VCAP_1), C24.1
unnamed: Accel_mc1.47 (VCAP_2), C27.1

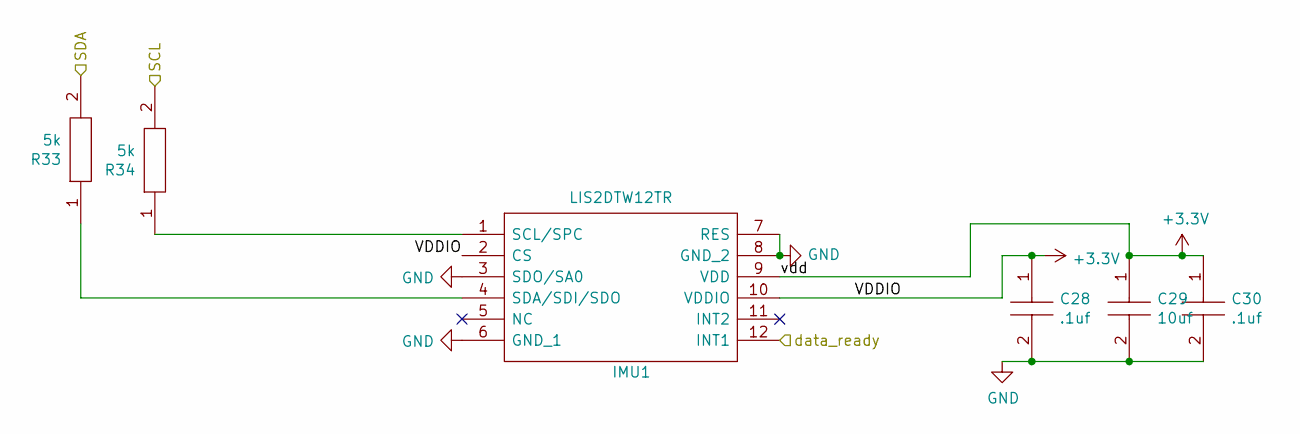
[picture p60: schematic IMU.sch]

Parts:
C28, C30: .1uf; CAPC1005X55N; Mouser Part Number 81-GRM155R62A104KE4D
C29: 10uf; CAPC2012X145N; Mouser Part Number 81-GRM21BR61E106KA3K
IMU1: LIS2DTW12TR; IIS2MDCTR; Mouser Part Number 511-LIS2DTW12TR
R33, R34: 5k; RESC1608X55N; Mouser Part Number 594-MCT0603PD4991DP5

Connections:
+3V3: C28.1, C29.1, C30.1, IMU1.2 (CS), IMU1.9 (VDD), IMU1.10 (VDDIO); also elsewhere on the board
/Controller/IMU_data_ready: IMU1.12 (INT1); also elsewhere on the board
/Controller/SCL: R34.2; also elsewhere on the board
/Controller/SDA: R33.2; also elsewhere on the board
GND: C28.2, C29.2, C30.2, IMU1.3 (SDO/SA0), IMU1.6 (GND_1), IMU1.7 (RES), IMU1.8 (GND_2); also elsewhere on the board
unnamed: IMU1.1 (SCL/SPC), R34.1
unnamed: IMU1.4 (SDA/SDI/SDO), R33.1

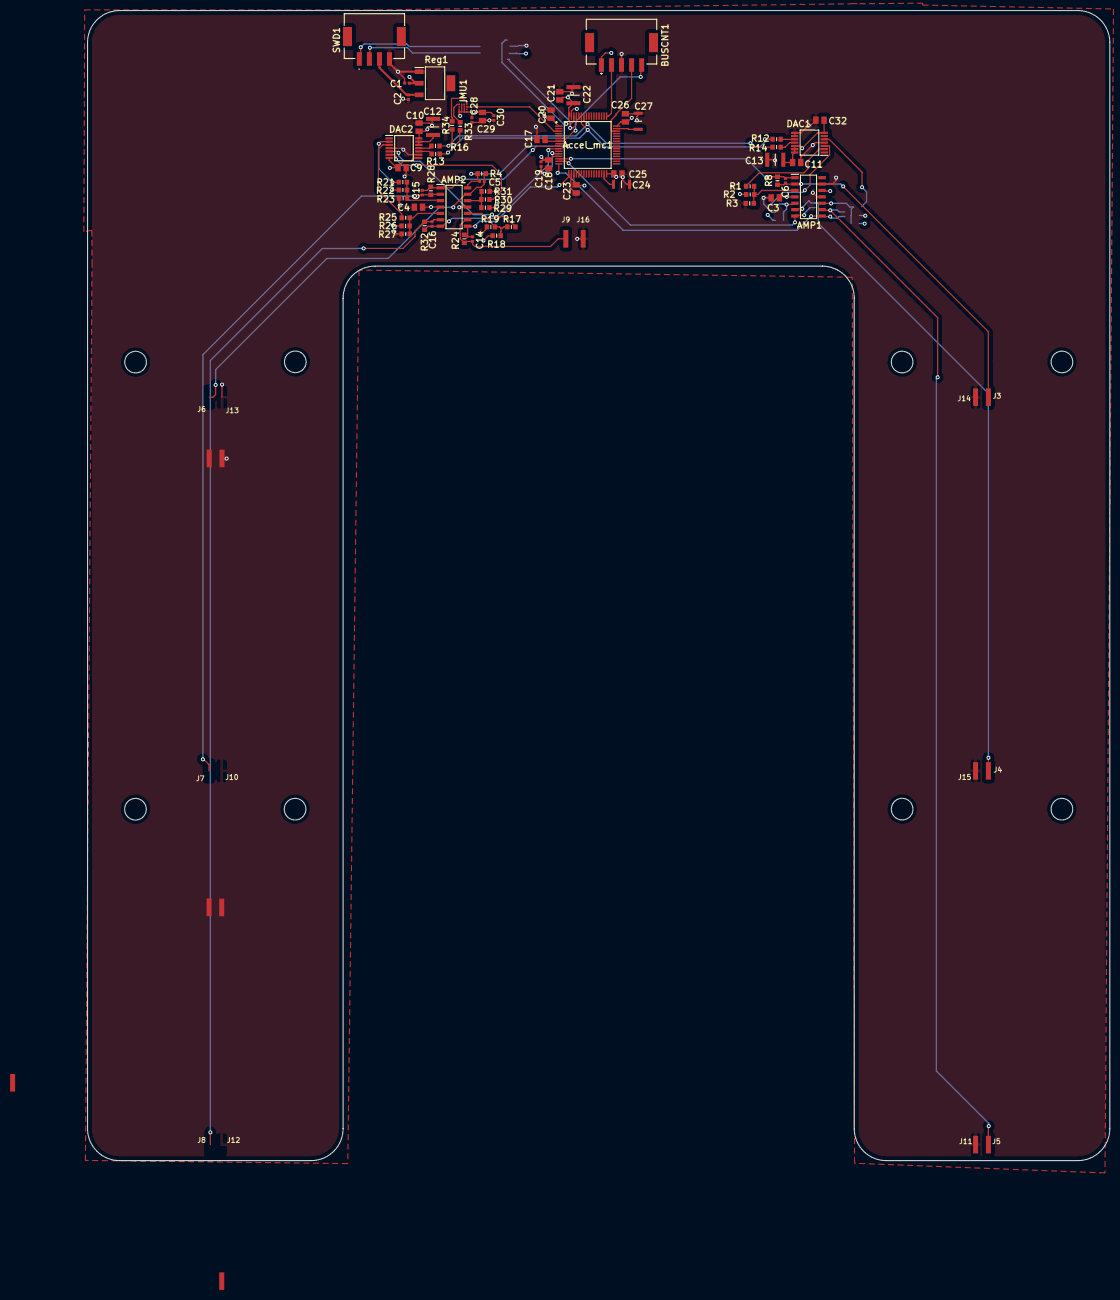
[picture p61: board Forward_acceleration_board.kicad_pcb from above]

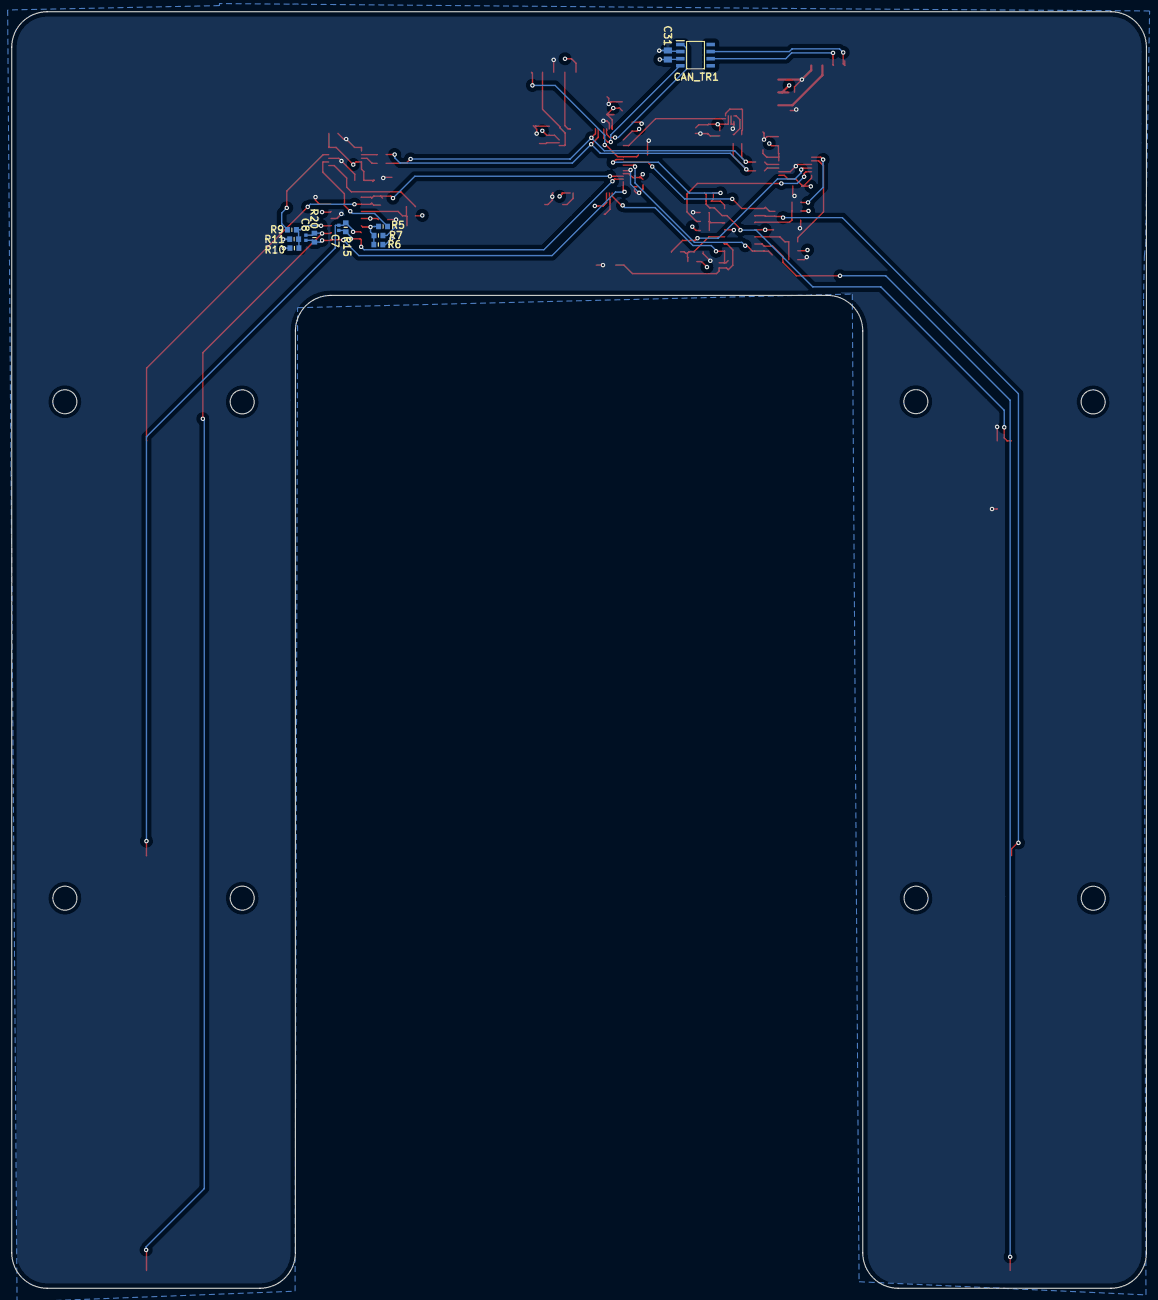
[picture p62: board Forward_acceleration_board.kicad_pcb from below]

Board: 4 copper layers, 203.2 x 228.6 mm, 90 parts (12 on the bottom side), 49 nets.
