goldstar971/Movin_on/Code/configuration_DSC/configuration_DSC.ioc

Mcu.UserName=STM32F765VITx
PA1.GPIO_Label=phase_1_curr
PA1.Signal=ADCx_IN1
PA11.Signal=CAN1_RX
PA12.Signal=CAN1_TX
PA13.Signal=SYS_JTMS-SWDIO
PA14.Signal=SYS_JTCK-SWCLK
PA15.Signal=GPIO_Input
PA2.GPIO_Label=phase_2_curr
PA2.Signal=ADCx_IN2
PA3.Signal=GPIO_Input
PA4.GPIO_Label=phase_3_curr
PA4.Signal=ADCx_IN4
PA5.GPIO_Label=V_battery_supply
PA5.Signal=ADCx_IN5
PB10.Signal=I2C2_SCL
PB11.Signal=I2C2_SDA
PB12.Signal=GPIO_Input
PB2.Signal=GPIO_Input
PB3.Signal=GPIO_Input
PB4.Signal=GPIO_Input
PB5.Signal=GPIO_Input
PB6.Signal=GPIO_Input
PB7.Signal=GPIO_Input
PB8.Signal=GPIO_Input
PB9.Signal=GPIO_Input
PC0.GPIO_Label=V_phase_1
PC0.Signal=ADCx_IN10
PC1.GPIO_Label=V_phase_2
PC1.Signal=ADCx_IN11
PC10.Signal=GPIO_Input
PC11.Signal=GPIO_Input
PC12.Signal=GPIO_Input
PC13.Signal=GPIO_Input
PC14/OSC32_IN.GPIO_Label=LED_GREEN
PC14/OSC32_IN.Signal=GPIO_Output
PC15/OSC32_OUT.GPIO_Label=LED_RED
PC15/OSC32_OUT.Signal=GPIO_Output
PC2.GPIO_Label=V_phase_3
PC2.Signal=ADCx_IN12
PC3.GPIO_Label=Pfet_temp
PC3.Signal=ADCx_IN13
PC4.Signal=GPIO_Input
PC5.Signal=GPIO_Input
PC6.Signal=S_TIM8_CH1
PC9.Signal=GPIO_Input
PD10.Signal=GPIO_Input
PD11.Signal=GPIO_Input
PD12.Signal=GPIO_Input
PD13.Signal=GPIO_Input
PD14.Signal=GPIO_Input
PD15.Signal=GPIO_Input
PD2.Signal=GPIO_Input
PD3.Signal=GPIO_Input
PD4.Signal=GPIO_Input
PD5.Signal=GPIO_Input
PD6.Signal=GPIO_Input
PD7.Signal=GPIO_Input
PD8.Signal=GPIO_Input
PD9.Signal=GPIO_Input
PE0.Signal=GPIO_Input
PE1.Signal=GPIO_Input
PE10.GPIO_Label=INL2
PE10.Signal=TIM1_CH2N
PE11.GPIO_Label=INH2
PE11.Signal=S_TIM1_CH2
PE12.GPIO_Label=INL3
PE12.Signal=TIM1_CH3N
PE13.GPIO_Label=INH3
PE13.Signal=S_TIM1_CH3
PE14.GPIO_Label=En_Gate
PE14.Signal=GPIO_Output
PE15.GPIO_Label=Fault
PE15.Signal=GPIO_Input
PE2.Signal=GPIO_Input
PE3.Signal=GPIO_Input
PE4.Signal=GPIO_Input
PE5.Signal=GPIO_Input
PE6.Signal=GPIO_Input
PE8.GPIO_Label=INL1
PE8.Signal=TIM1_CH1N
PE9.GPIO_Label=INH1
PE9.Signal=S_TIM1_CH1
PH0/OSC_IN.Signal=GPIO_Input
PH1/OSC_OUT.Signal=GPIO_Input
