goldstar971/Movin_on/Code/configuration_DSC/Inc/main.h

#define LED_GREEN_Pin GPIO_PIN_14
#define LED_GREEN_GPIO_Port GPIOC
#define LED_RED_Pin GPIO_PIN_15
#define LED_RED_GPIO_Port GPIOC
#define V_phase_1_Pin GPIO_PIN_0
#define V_phase_1_GPIO_Port GPIOC
#define V_phase_2_Pin GPIO_PIN_1
#define V_phase_2_GPIO_Port GPIOC
#define V_phase_3_Pin GPIO_PIN_2
#define V_phase_3_GPIO_Port GPIOC
#define Pfet_temp_Pin GPIO_PIN_3
#define Pfet_temp_GPIO_Port GPIOC
#define phase_1_curr_Pin GPIO_PIN_1
#define phase_1_curr_GPIO_Port GPIOA
#define phase_2_curr_Pin GPIO_PIN_2
#define phase_2_curr_GPIO_Port GPIOA
#define phase_3_curr_Pin GPIO_PIN_4
#define phase_3_curr_GPIO_Port GPIOA
#define V_battery_supply_Pin GPIO_PIN_5
#define V_battery_supply_GPIO_Port GPIOA
#define INL1_Pin GPIO_PIN_8
#define INL1_GPIO_Port GPIOE
#define INH1_Pin GPIO_PIN_9
#define INH1_GPIO_Port GPIOE
#define INL2_Pin GPIO_PIN_10
#define INL2_GPIO_Port GPIOE
#define INH2_Pin GPIO_PIN_11
#define INH2_GPIO_Port GPIOE
#define INL3_Pin GPIO_PIN_12
#define INL3_GPIO_Port GPIOE
#define INH3_Pin GPIO_PIN_13
#define INH3_GPIO_Port GPIOE
#define En_Gate_Pin GPIO_PIN_14
#define En_Gate_GPIO_Port GPIOE
#define Fault_Pin GPIO_PIN_15
#define Fault_GPIO_Port GPIOE
