goldstar971/Movin_on/Code/AN1078 Source Code for dsPIC30F6010A_V1.0/Sensorless FOC for PMSM Motors. High Voltage Power Module. V1.0/Sensorless FOC for PMSM Motors/control.h

#ifndef Control_H
#define Control_H
//------------------  C API for Control routine ---------------------

typedef struct {
    short   qVelRef;    // Reference velocity
    short   qVdRef;     // Vd flux reference value
    short   qVqRef;     // Vq torque reference value
    } tCtrlParm;

tCtrlParm CtrlParm;
#endif
