goldstar971/Movin_on/Code/AN1078 Source Code for dsPIC30F6010A_V1.0/Sensorless FOC for PMSM Motors. High Voltage Power Module. V1.0/Sensorless FOC for PMSM Motors/bin2dec.h

#ifndef bin2dec_H
#define bin2dec_H

void adc2dec( unsigned int ADRES );
void bin2dec( unsigned long int ADRES );

//Provide the following variables global scope
EXTERN char adones;
EXTERN char adtenths;
EXTERN char adhundredths;
EXTERN char adthousandths;

EXTERN char tenthous ;
EXTERN char thousands ;					
EXTERN char hundreds ;
EXTERN char tens ;
EXTERN char ones ;

#endif
