goldstar971/Movin_on/Code/AN1078 Source Code for dsPIC30F6010A_V1.0/Sensorless FOC for PMSM Motors. High Voltage Power Module. V1.0/Sensorless FOC for PMSM Motors/pi.h

#ifndef PI_H
#define PI_H
//------------------  C API for PI routines ---------------------

typedef struct {
    long    qdSum;          // 1.31 format
    short   qKp;
    short   qKi;
    short   qKc;
    short   qOutMax;
    short   qOutMin;
    short   qInRef; 
    short   qInMeas;
    short   qOut;
    } tPIParm;

void InitPI( tPIParm *pParm);
void CalcPI( tPIParm *pParm);
#endif
