goldstar971/Movin_on/Code/AN1078 Source Code for dsPIC30F6010A_V1.0/Sensorless FOC for PMSM Motors. High Voltage Power Module. V1.0/Sensorless FOC for PMSM Motors/svgen.h

#ifndef SVGen_H
#define SVGen_H
//------------------  C ASVGen for SVGen routines ---------------------

typedef struct {
    short   iPWMPeriod;

    short   qVr1;
    short   qVr2;
    short   qVr3;

    } tSVGenParm;

void CalcRefVec( void );
void CalcSVGen( void );
void CorrectPhase( void );

tSVGenParm SVGenParm;
#endif
