goldstar971/Movin_on/(commit log)

2019-06-05 Initial setup including all work done so far Models for motor control PCB, Text schematic and BMS for same :
    [BOM.xlsx, Electrical_components_list_motor_control.ods, MSD I Self-critique.xlsx, Peer Evaluation Template.xlsx, Problem Tracking Template.xlsx, Requirements and Testing.xlsx, Risk Management template.xlsx, concept screening matrix template.xlsx]
2019-06-22 Removed SVN and code blocks code folder
    [Electrical_components_list_motor_control.ods, electrical_components_list_acceleration_control.ods, electrical_components_list_forward_acceleration_control.ods, test.kicad_pcb, test.sch]
2019-06-27 updated motor control pcb text document, motor control BMS. Begining of motor control coding project.
    [Electrical_components_list_motor_control.ods, dsc_pinout.csv]
2019-06-27 remove duplicate and uncessary files
    [Electrical_components_list_motor_control.ods]
2019-07-20 added Simulink project for modeling FOC algorithm modified motor control pcb notes and BOM to use 4 330UF aluminum electrolytic capacitors (EEE-FT1H331AP) in place of 2 680 UF capacitors (EEV-FK1J681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
    [Electrical_components_list_motor_control.ods, motor_hardware.slx.type.File.xml]
2019-08-06 Completed first iteration of PCB design for the BLDC motor controller Completed schematic stored symbol, footprint and model libraries in a convient location for ease of access in the program. Altere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
    [875015119003.stl, 875015119003.stp, AD8418ABRMZ.stl, AD8418ABRMZ.stp, AS0805KKX7R0BB104.stl, AS0805KKX7R0BB104.stp, BA17805FP-E2.stp, C0603C121J5GACTU.stl]
2019-08-06 Updated PCB
    [DSC_motor_controller.kicad_pcb]
2019-08-07 Add files via upload
    pcb work done on work computer
    [CAN.sch, DSC_motor_controller.kicad_pcb, DSC_motor_controller.sch, Motor_Driver.sch, Motor_controller.sch, Power.sch]
2019-08-08 PCB version that will be given to Eric's friend for review
    [CAN.sch, DSC_motor_controller.kicad_pcb, DSC_motor_controller.sch, Motor_Driver.sch, Motor_controller.sch, Power.sch, _saved_Power.sch]
2019-09-11 updated pcb files, deleted redundant code files"
    [CAN.sch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]
2019-09-30 updated all files
    [AS0805KKX7R0BB104.stl, AS0805KKX7R0BB104.stp, C0805C224J5NACTU.stl, C0805C224J5NACTU.stp, C3216X7R1H225K160AE.stl, C3216X7R1H225K160AE.stp, CAN.sch, CGA6M3X7S2A475K200AB.stl]
2019-10-09 reogranized file locations, improved DSC controller pcb with edged margin on edges and rounded corners. Completed Acceleration control board schematic
    [CAN.sch, Controller.sch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]
2019-10-20 nearly completed forward acceleration control board rounded edges and established clearence for motor control board made progress canabalizing Vedder's code for motor control
    [DSC Run.cfg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]
2019-10-25 Code and PCB modifications
    Adjustments to DSC motor controller PCB as well as BOMs
    Nearly completed cannibalization of VESC code for the DSC motor control
    application.
    [CAN.sch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]
2019-11-14 replaced 220nf resistor with component that fit, moved silkscreen around, updated BOM
    [C0805C224J5NACTU.stl, C0805C224J5NACTU.stp, CAN.sch, DSC_motor_controller.kicad_pcb, DSC_motor_controller.sch, EDI2CAP.CFG, Electrical_components_list_motor_control.ods, Forward_acceleration_board.kicad_pcb]
2019-11-22 updated BOMS for boards and added battery pack wiring schematic
    [CAN.sch, Controller.sch, DSC_motor_controller.kicad_pcb, EDI2CAP.CFG, FSR_circuitry.sch, Forward_acceleration_board.kicad_pcb, Forward_acceleration_board.sch, GRM155R62A104KE14D.stl]
